spa-pal/UKU201/HARD_v3/Ошибки.docx

Ошибки первого варианта платы.

1. 5 нога JP6 не разведена на GND. Ошибка в принципиалке, указана цепь SGND.
2. Разъем JP4 не входит по отверстиям. Увеличить на пару соток.
