spa-pal/UKU201/HARD_v3/Project Outputs for UKU201/uku201_1.xls

Comment | Designator | Footprint | Quantity
HCM1205X | A1 | zumm | 1.0
796136-1 | BT1 | BAT_HOLD_SMD | 1.0
100n | C1 | _1206 | 1.0
10pF | C2, C4, C9, C10 | _1206 | 4.0
22.0 | C3 | _1206 | 1.0
1.0 | C5, C12, C13, C14, C15, C17, C19, C20, C21, C22, C23, C24, C26, C27, C28, C29 | _1206 | 16.0
LXZ 220x16 | C6, C18, C25 | el3 | 3.0
33pF | C7, C8 | _1206 | 2.0
10.0 | C11 | _1206 | 1.0
1n0 | C16 | _1206 | 1.0
MBR0520 | D1, D2, D3, D4 | _1206d | 4.0
BAV103 | D5 | _1206d | 1.0
LED0 | D6, D7, D8, D9 | el3 | 4.0
BZV55-C5V6 | D10 | _1206d | 1.0
BZV55-C3V3 | D11 | _1206d | 1.0
PBD-10 | JP1 | HDR2X10 | 1.0
PBD-10 | JP2 | HDR2X5 | 1.0
LBH-10R | JP3 | SCM-10MR | 1.0
Header 2 | JP4 | 2EDGR-5.0-2P | 1.0
CORTEX_DEBUG_CONNECTOR_PAL | JP5 | CORTEX_DEBUG_CONNECTOR | 1.0
UART_PORT | JP6 | HDR1X5_uart | 1.0
2EDGR-5.08-02P | JP7 | HDR1X2 | 1.0
BC847 | Q1 | SO-G3 | 1.0
IRF7103 | Q7, Q8 | SO-G8/Y2.2 | 2.0
BC856 | Q501 | SO-G3 | 1.0
0R | R1, R2 | _1206 | 2.0
560R | R3, R4 | _1206 | 2.0
JVR07N | R5, R6 | JVR07N | 2.0
22R | R8 | _1206 | 1.0
5K1 | R9 | _1206 | 1.0
10K | R10, R25, R27, R29, R33, R34, R35, R36, R39, R40, R77, R78 | _1206 | 12.0
2K7 | R11, R12, R32 | _1206 | 3.0
1K0 | R13, R14, R15, R16, R17, R18, R19, R20, R22, R24, R26, R28, R30, R31 | _1206 | 14.0
33K | R21, R23 | _1206 | 2.0
100R | R37, R38 | _1206 | 2.0
SWT-3 | S1 | SWT-6R | 1.0
ISO7231 | U1 | SO-G16/D10.4 | 1.0
MCP2515 | U2 | TSSO6X6-G20/D6.6 | 1.0
TJA1050 | U3 | SO-G8/D5 | 1.0
SN6501DBVR | U4, U8 | SO-G5/P.95 | 2.0
II 130 404 21 01 | U5, U9 | II1304042101 | 2.0
STM32F103RC | U6 | F-QFP10X10-G64/N | 1.0
25LC640 | U7 | SO-G8/D5 | 1.0
ADM2483 | U10 | SO-G16/D10.4 | 1.0
LD1117-3.3 | U11 | DSO-G3 | 1.0
AD158X | U12 | so-g3 | 1.0
8MGz | Y1 | QWARZ1 | 1.0
32768 | Y2 | QWARZ2 | 1.0
10MGz | Y3 | QWARZ1 | 1.0
