spa-pal/UKU201/HARD_v3/Project Outputs for UKU201/uku201.xls

Designator | Comment | Footprint | Quantity
A1 | HCM1205X | zumm | 1.0
BT1 | 796136-1 | BAT_HOLD_SMD | 1.0
C1 | 100n | _1206 | 1.0
C2, C4, C9, C10 | 10pF | _1206 | 4.0
C3 | 22.0 | _1206 | 1.0
C5, C11, C12, C13, C14, C15, C17, C19, C20, C21, C22, C23, C24, C26, C27, C28, C29 | 1.0 | _1206 | 17.0
C6, C18, C25 | LXZ 220x16 | el3 | 3.0
C7, C8 | 33pF | _1206 | 2.0
C16 | 1n0 | _1206 | 1.0
D1, D2, D3, D4 | MBR0520 | _1206d | 4.0
D5 | BAV103 | _1206d | 1.0
D6, D7, D8, D9 | LED0 | el3 | 4.0
D10 | 5V6 | _1206d | 1.0
JP1 | PBD-10 | HDR2X10 | 1.0
JP2 | PBD-10 | HDR2X5 | 1.0
JP3 | LBH-10R | SCM-10MR | 1.0
JP4 | 2EDGR-5.08-02P | 2EDGR-5.0-2P | 1.0
JP5 | CORTEX_DEBUG_CONNECTOR_PAL | CORTEX_DEBUG_CONNECTOR | 1.0
JP6 | UART_PORT | HDR1X5_uart | 1.0
JP7 | 2EDGR-5.08-02P | HDR1X2 | 1.0
Q1 | BC847 | SO-G3 | 1.0
Q7, Q8 | IRF7103 | SO-G8/Y2.2 | 2.0
Q501 | BC856 | SO-G3 | 1.0
R1, R2 | 0R | _1206 | 2.0
R3, R4 | 560R | _1206 | 2.0
R5, R6 | JVR07N | JVR07N | 2.0
R7, R37, R38 | 100R | _1206 | 3.0
R8 | 22R | _1206 | 1.0
R9 | 5K1 | _1206 | 1.0
R10, R25, R27, R29, R33, R34, R35, R36, R39, R77, R78 | 10K | _1206 | 11.0
R11, R12, R32 | 2K7 | _1206 | 3.0
R13, R14, R15, R16, R17, R18, R19, R20, R22, R24, R26, R28, R30, R31 | 1K0 | _1206 | 14.0
R21, R23 | 33K | _1206 | 2.0
S1 | SWT-3 | SWT-6R | 1.0
U1 | ISO7231 | SO-G16/D10.4 | 1.0
U2 | MCP2515 | TSSO6X6-G20/D6.6 | 1.0
U3 | TJA1050 | SO-G8/D5 | 1.0
U4, U8 | SN6501DBVR | SO-G5/P.95 | 2.0
U5, U9 | II 130 404 21 01 | II1304042101 | 2.0
U6 | STM32F103RC | F-QFP10X10-G64/N | 1.0
U7 | 25LC640 | SO-G8/D5 | 1.0
U10 | ADM2483 | SO-G16/D10.4 | 1.0
U11 | LD1117-3.3 | DSO-G3 | 1.0
Y1 | 8MGz | QWARZ1 | 1.0
Y2 | 32768 | QWARZ2 | 1.0
Y3 | 10MGz | QWARZ1 | 1.0
