spa-pal/UKU201/HARD_v3/Project Outputs for UKU201/uku201.xlsx

Designator | Comment | Footprint | Quantity
A1 | HCM1205X | zumm | 1
BT1 | 796136-1 | BAT_HOLD_SMD | 1
C1 | 100n | _1206 | 1
C2, C4, C9, C10 | 10pF | _1206 | 4
C3 | 22.0 | _1206 | 1
C5, C11, C12, C13, C14, C15, C17, C19, C20, C21, C22, C23, C24, C26, C27, C28, C29 | 1.0 | _1206 | 17
C6, C18, C25 | LXZ 220x16 | el3 | 3
C7, C8 | 33pF | _1206 | 2
C16 | 1n0 | _1206 | 1
D1, D2, D3, D4 | MBR0520 | _1206d | 4
D5 | BAV103 | _1206d | 1
D10 | 5V6 | _1206d | 1
JP3 | LBH-10R | SCM-10MR | 1
JP4 | 2EDGR-5.08-02P | 2EDGR-5.0-2P | 1
Q1 | BC847 | SO-G3 | 1
Q7, Q8 | IRF7103 | SO-G8/Y2.2 | 2
Q501 | BC856 | SO-G3 | 1
R3, R4 | 560R | _1206 | 2
R5, R6 | JVR07N | JVR07N | 2
R7, R37, R38 | 100R | _1206 | 3
R8 | 22R | _1206 | 1
R9 | 5K1 | _1206 | 1
R10, R25, R27, R29, R33, R34, R35, R36, R39, R77, R78 | 10K | _1206 | 11
R11, R12, R32 | 2K7 | _1206 | 3
R13, R14, R15, R16, R17, R18, R19, R20, R22, R24, R26, R28, R30, R31 | 1K0 | _1206 | 14
R21, R23 | 33K | _1206 | 2
S1 | SWT-3 | SWT-6R | 1
U1 | ISO7231 | SO-G16/D10.4 | 1
U2 | MCP2515 | TSSO6X6-G20/D6.6 | 1
U3 | TJA1050 | SO-G8/D5 | 1
U4, U8 | SN6501DBVR | SO-G5/P.95 | 2
U5, U9 | II 130 404 21 01 | II1304042101 | 2
U6 | STM32F103RC | F-QFP10X10-G64/N | 1
U7 | 25LC640 | SO-G8/D5 | 1
U10 | ADM2483 | SO-G16/D10.4 | 1
U11 | LD1117-3.3 | DSO-G3 | 1
Y1 | 8MGz | QWARZ1 | 1
Y2 | 32768 | QWARZ2 | 1
Y3 | 10MGz | QWARZ1 | 1
