spa-pal/UKU201/OUT_DOCS/can.pdf

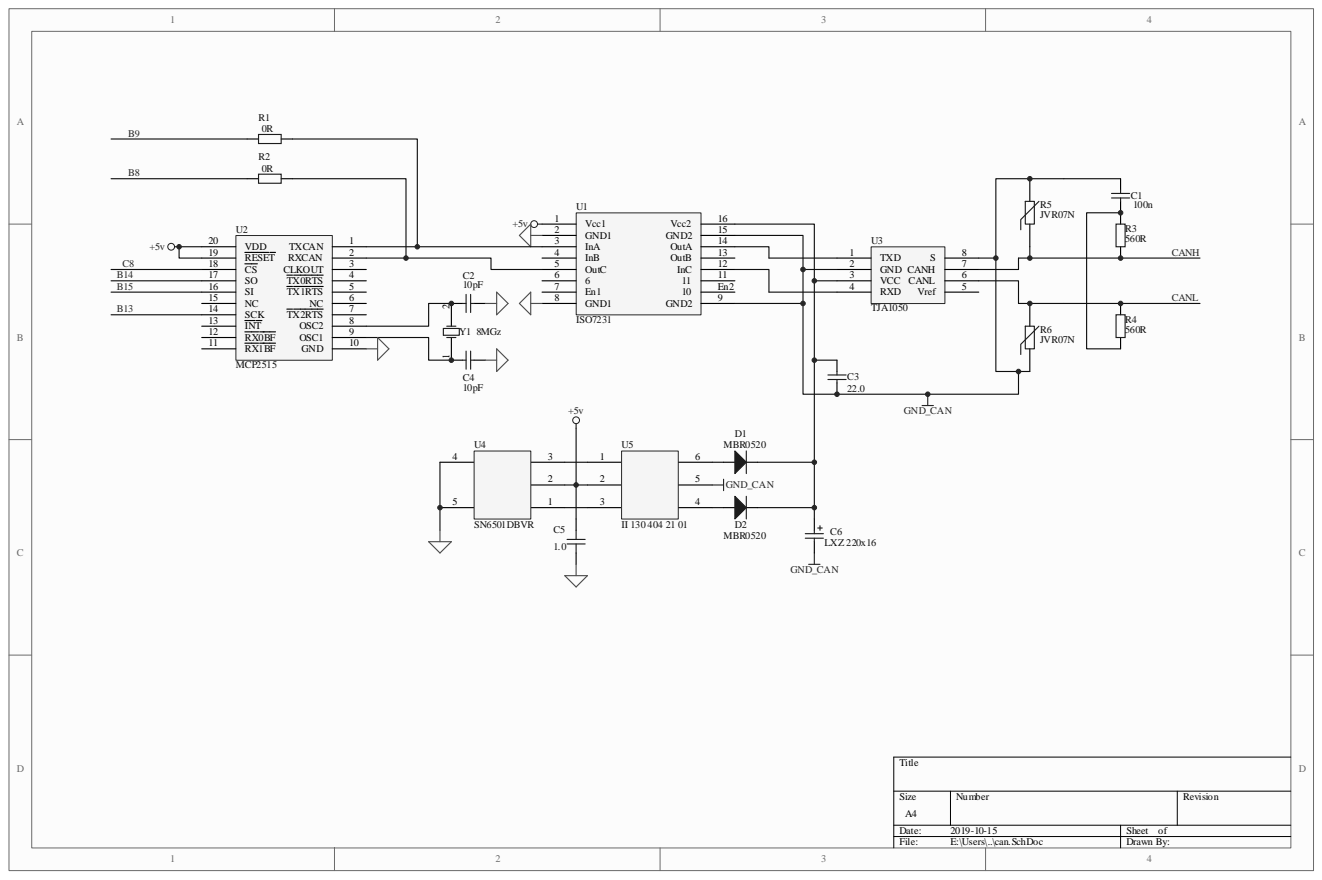
[picture p1: page 1]

Size A4 | Number | Revision

Date: 2019-10-15 | Sheet of
File: E:\Users\..\can.SchDoc | Drawn By:
