spa-pal/UKU201/OUT_DOCS/cpu_board.pdf

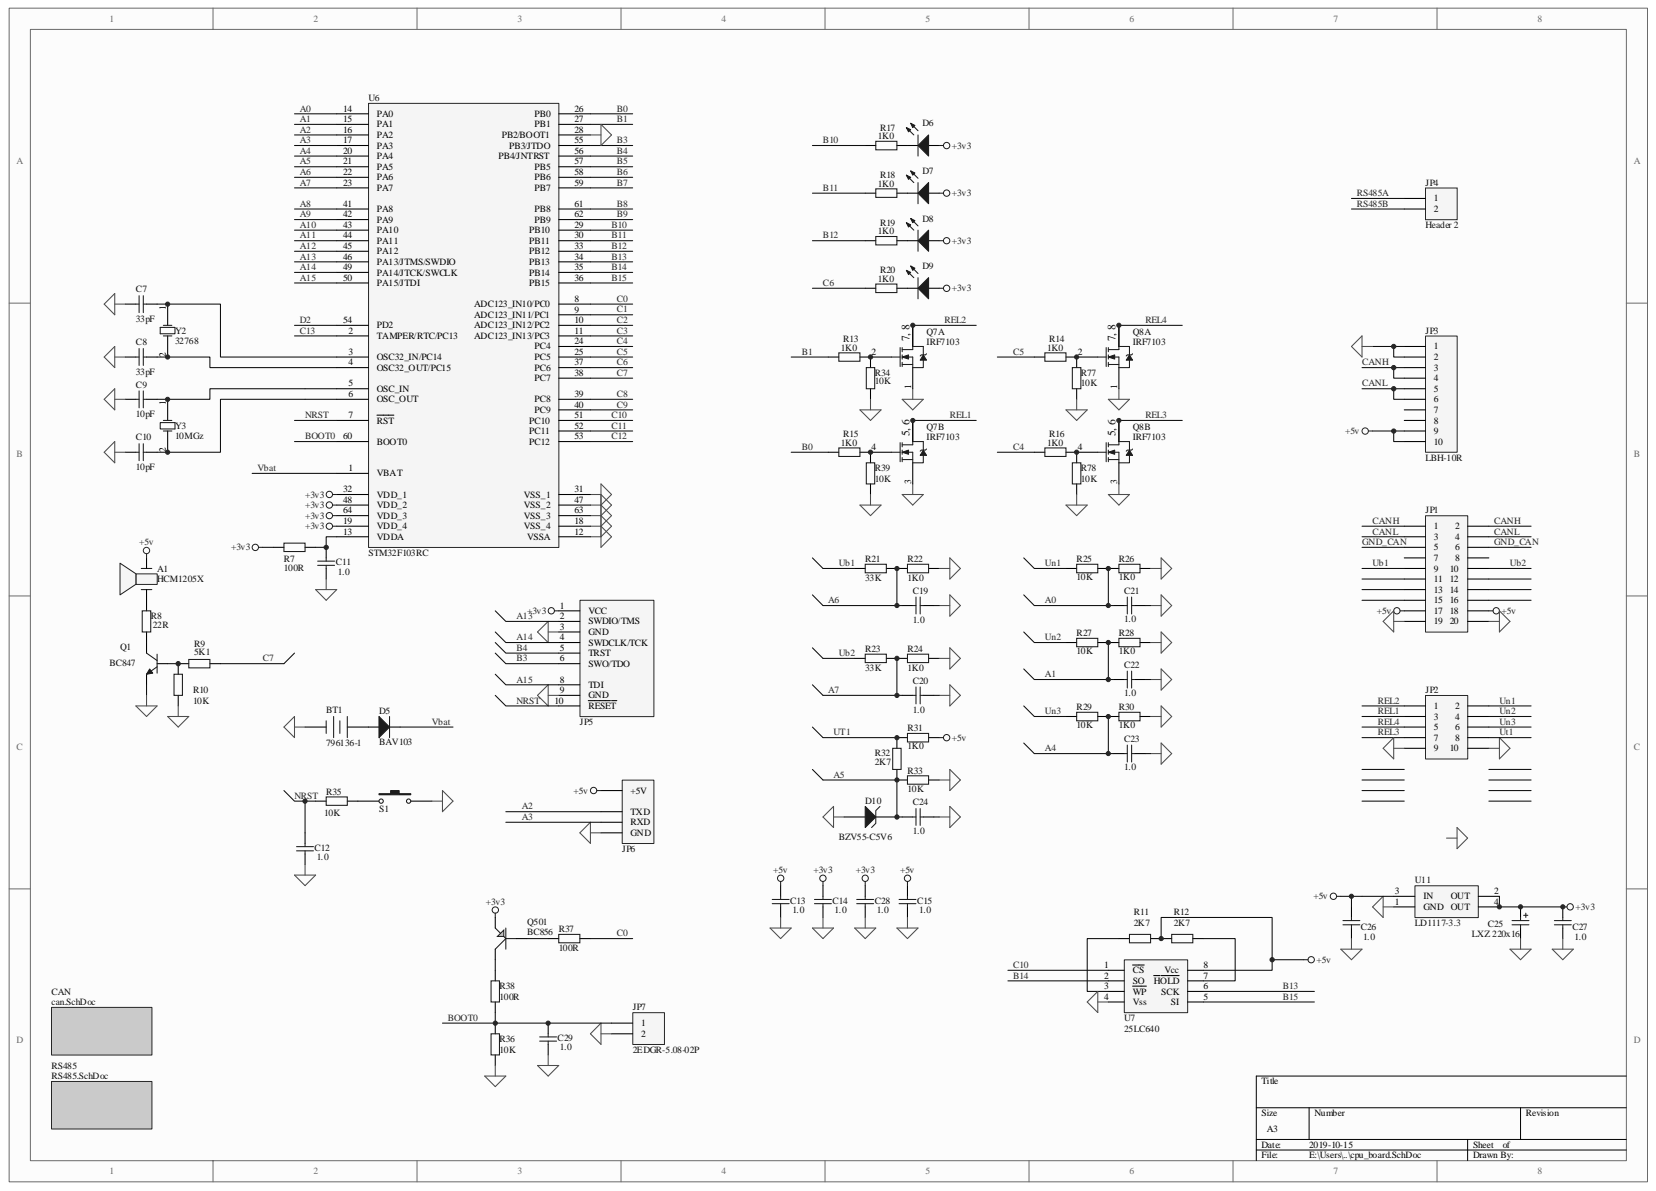
[picture p2: page 1]

Size A3 | Number | Revision

Date: 2019-10-15 | Sheet of
File: E:\Users\..\cpu_board.SchDoc | Drawn By:
