spa-pal/UKU201/OUT_DOCS/pcb.pdf

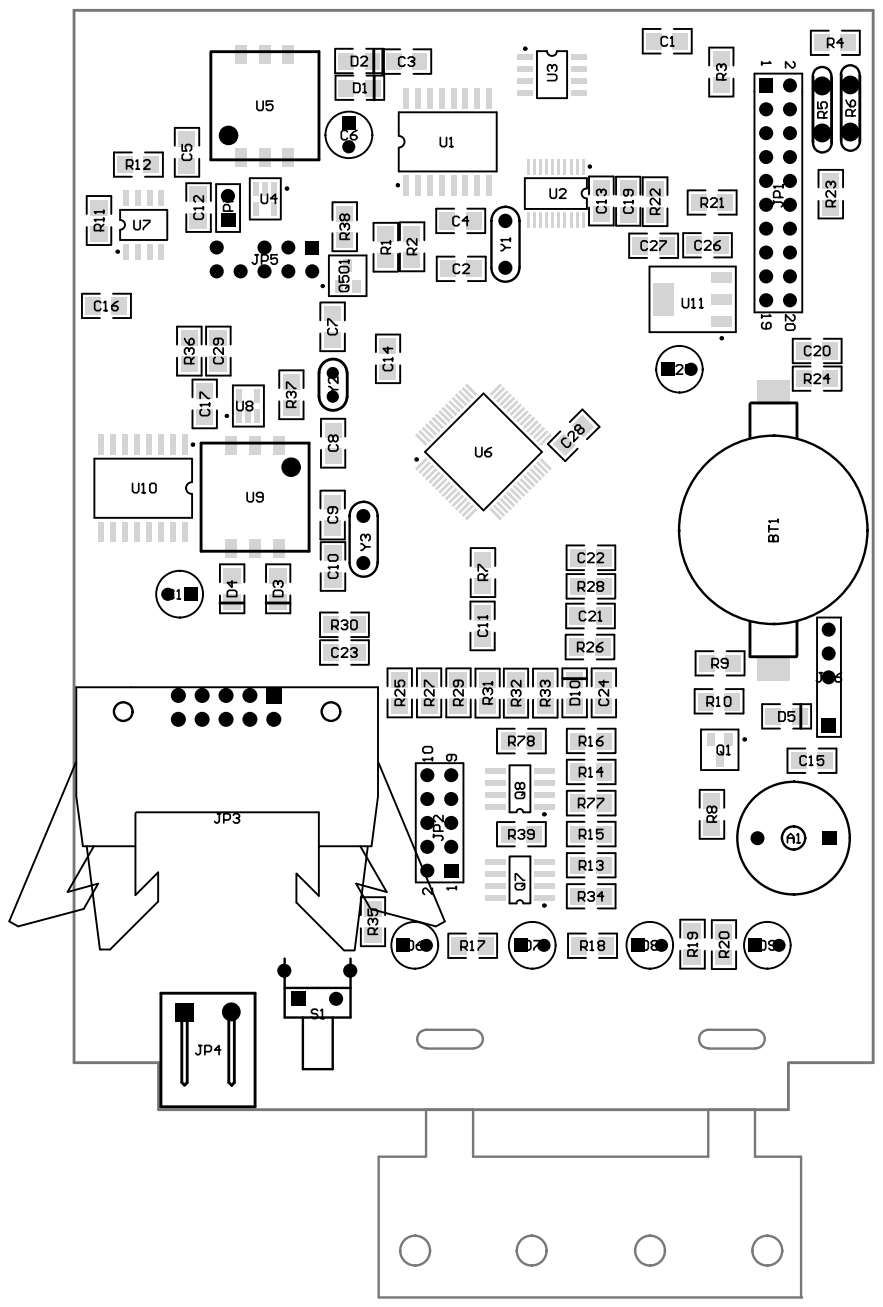
[picture p3: page 1]
