spa-pal/UKU201/OUT_DOCS/rs485.pdf

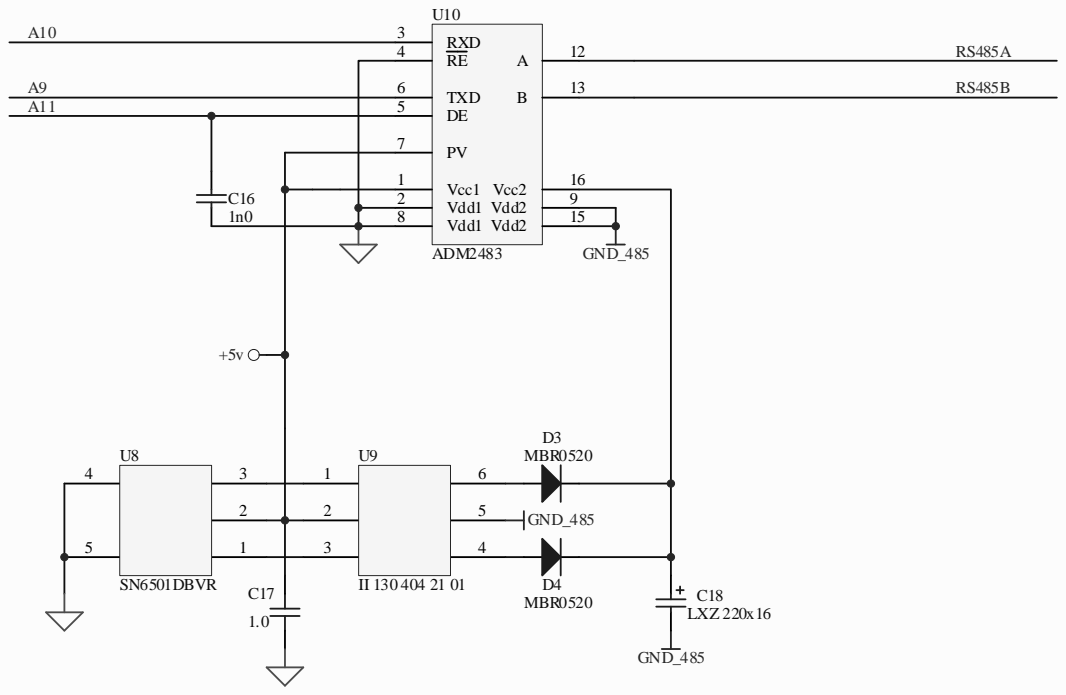
[picture p4: page 1]

Size A4 | Number | Revision

Date: 2019-10-15 | Sheet of
File: E:\Users\..\rs485.SchDoc | Drawn By:
