spa-pal/UKU201/(list of files, drawings)

Other design files:
HARD_v3/can.SchDoc
HARD_v3/cpu_board.SchDoc
HARD_v3/rs485.SchDoc
HARD_v3/uku201.PcbDoc
HARD_v3/UKU201.PrjPCB
