spa-pal/UKU201/SOFT/1/main.c

#include <stm32f10x_conf.h>
#include <string.h>                   /* string and memory functions         */
#include "STM32_Init.h"               /* stm32 initialisation                */
#include <stm32f10x_lib.h>
#include "STM32_Reg.h"
#include "main.h"
#include "uart1.h"
#include "uart2.h"
#include "modbus.h"
#include "25lc640.h"
#include "eeprom_map.h"
#include "memo.h"
#include "mess.h"
#include "control.h"
#include "cmd.h"
#include "full_can.h"
#include "mcp2515.h"
#include "avar_hndl.h"
#include "beep.h"
#include "stm32_rtc.h"

#define	putchar putchar2
#define can1_out mcp2515_transmit

#define SEC_IN_DAY 86400

//***********************************************
//Тайминги
unsigned char t0cnt0, t0cnt1, t0cnt2, t0cnt3, t0cnt4, t0cnt5; 
bool b1000Hz, b100Hz, b50Hz, b1Hz, b10Hz, b5Hz, b2Hz;
bool bFL, bFL2, bFL5;
signed short main_10Hz_cnt;
signed short main_1Hz_cnt;
short main_1HZ_cnt;


//***********************************************
//Данные из EEPROM
signed short ICA_MODBUS_ADDRESS;//Адрес ведомого для выравнивания токов по шине MODBUS-RTU
signed short MODBUS_ADRESS=1;
signed int MODBUS_BAUDRATE=115200;

//***********************************************
//Состояние первичной сети
signed short net_U,net_Ustore,net_Ua,net_Ub, net_Uc, net_Umax;
char bFF,bFF_;
signed short net_F,hz_out,hz_out_cnt,net_F3;
signed char unet_drv_cnt;	//Счетчик на снижение первичного наряжеия
signed char unet_max_drv_cnt; //Счетчик на превышение первичного наряжеия
char net_av;		//аварийность питающей сети 0 - норма, 1 - занижено, 2 - завышено

//***********************************************
//Состояние батарей
BAT_STAT bat[2],bat_ips;
signed short		bat_u_old_cnt;
signed short 		Ib_ips_termokompensat;
signed short		Ib_ips_termokompensat_temp;

//***********************************************
//Состояние источников
BPS_STAT bps[40];

//***********************************************
//Состояние выхода
signed short bps_U;
signed short out_U;
signed short bps_I;
signed short bps_I_phantom;

//***********************************************
//Состояние нагрузки
signed short load_U;
signed short load_I;

//***********************************************
//Ускоренный заряд
signed short speedChrgCurr;			//максимальный ток ускоренного заряда, отображение из ЕЕПРОМ
signed short speedChrgVolt;			//максимальное напряжение ускоренного заряда, отображение из ЕЕПРОМ
signed short speedChrgTimeInHour; 		//максимальное время ускоренного заряда в часах, отображение из ЕЕПРОМ
signed short speedChrgAvtEn;	    		//Автоматическое включение Ускоренного заряда включено/выключено
signed short speedChrgDU;	    		//Просадка напряжения необходимая для включения ускоренного заряда
signed short speedChIsOn;			//Текущее состояние ускоренного заряда вкл/выкл
signed long  speedChTimeCnt;			//Счетчик времени прямой ускоренного заряда
//signed short speedChrgBlckSrc;		//Источник сигнала блокировки, 0-выкл., 1-СК1, 2-СК2
//signed short speedChrgBlckLog;		//Логика сигнала блокировки, 1 - блокировка по замкнутому СК, 0 - по разомкнутому
signed short speedChrgBlckStat;		//Сигнал блокировки для выравнивающего и ускоренного заряда.
char  	   	 speedChrgShowCnt;		//Счетчик показа информационного сообщения
signed short SP_CH_VENT_BLOK;		//Блокировка ускоренного заряда вентиляцией (0-выкл, 1-замыканием, 2-размыканием)
char spch_plazma[2];

//***********************************************
//Новый ускоренный заряд
enum_sp_ch_stat sp_ch_stat=scsOFF,sp_ch_stat_old;
short sp_ch_stat_cnt;
long sp_ch_wrk_cnt;
char speedChargeStartCnt=0;

/*
//***********************************************
//Контроль выходного напряжения
signed short outVoltContrHndlCnt;		//Счетчик, считает в плюс в случае выполнения условия аварии
signed short outVoltContrHndlCnt_;		//Счетчик, считает в плюс в случае отсутствия выполнения условия аварии
char uout_av; */

//***********************************************
//Межблоковая связь
signed short cnt_net_drv;
char max_net_slot;
bool bCAN_OFF;

//***********************************************
//Спецфункции
enum_spc_stat spc_stat;
char spc_bat;
char spc_phase;
unsigned short vz_cnt_s,vz_cnt_s_,vz_cnt_h,vz_cnt_h_;
char bAVZ;
enum_ke_start_stat ke_start_stat;
short cnt_end_ke;
unsigned long ke_date[2];
short __ee_vz_cnt;
short __ee_spc_stat;
short __ee_spc_bat;
short __ee_spc_phase;
char vz_error=0;  		// устанавливается, если выравнивающий заряд заблокирован по вентиляции
char sp_ch_error=0;		// устанавливается, если ускоренный заряд заблокирован по вентиляции
char vz1_error=0;		// устанавливается, если уравнительный заряд заблокирован по вентиляции
char vz2_error=0;		// устанавливается, если формовочный заряд заблокирован по вентиляции

//**********************************************
//Коэффициенты, отображаемые из EEPROM
signed short Ktsrc[2];
signed short Kusrc[2];
signed short Kisrc[2];
signed short Ki0src[2];
signed short Kubat[2];
signed short Kubatm[2];
unsigned short Kibat0[2];
signed short Kibat1[2];
signed short Ktbat[2];
signed short Kunet;
signed short Kunet_ext[3];
signed short Ktext[3];
signed short Kuload;
signed short KunetA;
signed short KunetB;
signed short KunetC;
signed short Kubps;
signed short Kuout=2;

signed short MAIN_IST;
signed short UMAX;
signed short UB0;
signed short UB20;
signed short TMAX;
signed short TSIGN;
signed short AV_OFF_AVT;
signed short USIGN;
signed short UMN;
signed short UMAXN;
signed short ZV_ON;
signed short IKB;
//signed short KVZ;
signed short UVZ;
signed short IMAX_VZ;
signed short IMAX;
signed short IMIN;
signed short APV_ON;
signed short IZMAX;
signed short U0B;
signed short TZAS;
signed short VZ_HR;
signed short TBAT;
signed short U_AVT;
signed short DU;
signed short PAR;
signed short TBATMAX;
signed short TBATSIGN;
signed short UBM_AV;
signed short RELE_LOG;
signed short TBOXMAX;
signed short TBOXREG;
signed short TBOXVENTMAX;
signed short TLOADDISABLE;
signed short TLOADENABLE;
signed short TBATDISABLE;
signed short TBATENABLE;
signed short TVENTON;
signed short TVENTOFF;
signed short TWARMON;
signed short TWARMOFF;
enum_releventsign RELEVENTSIGN;
signed short TZNPN;
signed short UONPN;
signed short UVNPN;
signed short dUNPN;
enum_npn_out NPN_OUT;
enum_npn_sign NPN_SIGN;
signed short TERMOKOMPENS;
signed short TBOXVENTON; 
signed short TBOXVENTOFF;
signed short TBOXWARMON; 
signed short TBOXWARMOFF;
signed short BAT_TYPE;	//Тип батареи. 0 - обычная свинцовая, 1-литиевая COSLIGHT, 2-литиевая SACRED SUN , 3-литиевая ZTT
signed short DU_LI_BAT;	//Параметр, определяющий напряжение содержания литиевой батареи
signed short FORVARDBPSCHHOUR;	//Периодичностьсмены ведущего источника в часах. Если 0 - функция выключена и ведущий первый источник
signed short NUMBAT;
signed short NUMBAT_TELECORE;
signed short NUMIST;
signed short NUMINV;
signed short NUMDT;
signed short NUMSK;
signed short NUMEXT;
signed short NUMAVT;
signed short NUMMAKB;
signed short NUMBYPASS;
signed short NUMBDR;
signed short NUMENMV;
signed short NUMPHASE;
signed short SMART_SPC = 1;
signed short U_OUT_KONTR_MAX;
signed short U_OUT_KONTR_MIN;
signed short U_OUT_KONTR_DELAY;
signed short DOP_RELE_FUNC;
signed short CNTRL_HNDL_TIME;	//Постоянная времени регулирования источников для Телекора
signed short USODERG_LI_BAT;	//Напряжение содержания литиевой батареи
signed short QSODERG_LI_BAT;	//Заряд при котором начинает действовать напряжение содержания литиевой батареи
signed short TVENTMAX;			//Максимальный ресурс вентилятора
signed short ICA_EN;			//Включенность режима выравнивания токов ИПС
signed short ICA_CH;			//Канал связи для выравнивания токов, 0 - MODBUS, 1 - MODBUS-TCP
signed short ICA_MODBUS_ADDRESS;//Адрес ведомого для выравнивания токов по шине MODBUS-RTU
signed short ICA_MODBUS_TCP_IP1,ICA_MODBUS_TCP_IP2,ICA_MODBUS_TCP_IP3,ICA_MODBUS_TCP_IP4;	//IP ведомого для выравнивания токов по шине MODBUS-TCP
signed short ICA_MODBUS_TCP_UNIT_ID;	//UNIT ID ведомого для выравнивания токов по шине MODBUS-TCP
signed short PWM_START;			//Начальный шим для ЭЛТЕХа
signed short KB_ALGORITM;		//2-х или 3-х ступеннчатый алгоритм проверки цепи батареи
signed short REG_SPEED;			//скорость регулирования, 1- стандартная, 2,3,4,5- замедленная в 2,3,4,5 раз
enum_apv_on APV_ON1,APV_ON2;
signed short APV_ON2_TIME;
signed short RS485_QWARZ_DIGIT;
signed short UVENTOFF;			//Напряжение (1в) при котором выключится вентиляция после окончания ВЗ или УСКЗ
signed short VZ_KIND;			//Тип выравнивающего заряда, 0 - обычный(исторический, повышение напряжения на время), 
								//1- высоковольтный, с контролем вентиляции и запросами к оператору
signed short SNTP_ENABLE;
signed short SNTP_GMT;

signed short RELE1SET;			//Настройка срабатываний реле1
								//0бит - инверсия (1 - срабатывание оточиванием, 0 - срабатывание обесточиванием)
								//1бит - авария питающей сети, занижено(1 - вкл)
								//2бит - авария питающей сети, завышено(1 - вкл)
								//3бит - тревога батареи (1 - вкл)
								//4бит - авария батареи (1 - вкл)
								//5бит - тревога выпрямителей (1 - вкл)
								//6бит - авария выпрямителей (1 - вкл)
								//7бит - авария выходного напряжения, занижено (1 - вкл)
								//8бит - авария выходного напряжения, завышено (1 - вкл)
signed short RELE2SET;			//Настройка срабатываний реле2, значение битов как и в реле1
signed short RELE3SET;		   	//Настройка срабатываний реле3, значение битов как и в реле1

signed short UZ_U;
signed short UZ_IMAX;
signed short UZ_T;

signed short FZ_U1;
signed short FZ_IMAX1;
signed short FZ_T1;
signed short FZ_ISW12;
signed short FZ_U2;
signed short FZ_IMAX2;
signed short FZ_T2;

//signed short RELE_SET_MASK[4]={1,2,3,4};

enum_bat_is_on BAT_IS_ON[2];
signed short BAT_DAY_OF_ON[2];
signed short BAT_MONTH_OF_ON[2];
signed short BAT_YEAR_OF_ON[2];
signed short BAT_C_NOM[2];
signed short BAT_RESURS[2];
signed short BAT_C_REAL[2];
//signed short BAT_TYPE[2];

unsigned short AUSW_MAIN;
unsigned long AUSW_MAIN_NUMBER;
unsigned short AUSW_DAY;
unsigned short AUSW_MONTH;
unsigned short AUSW_YEAR;
unsigned short AUSW_UKU;
unsigned short AUSW_UKU_SUB;
unsigned long AUSW_UKU_NUMBER;
unsigned long	AUSW_BPS1_NUMBER;
unsigned long  AUSW_BPS2_NUMBER;
unsigned short AUSW_RS232;
unsigned short AUSW_PDH;
unsigned short AUSW_SDH;
unsigned short AUSW_ETH;

signed short TMAX_EXT_EN[3];
signed short TMAX_EXT[3];
signed short TMIN_EXT_EN[3];
signed short TMIN_EXT[3];
signed short T_EXT_REL_EN[3];
signed short T_EXT_ZVUK_EN[3];
signed short T_EXT_LCD_EN[3];
signed short T_EXT_RS_EN[3];

signed short SK_SIGN[4];
signed short SK_REL_EN[4];
signed short SK_ZVUK_EN[4];
signed short SK_LCD_EN[4];
signed short SK_RS_EN[4];

enum_avz AVZ;

unsigned short HOUR_AVZ;
unsigned short MIN_AVZ;
unsigned short SEC_AVZ;
unsigned short DATE_AVZ;
unsigned short MONTH_AVZ;
unsigned short YEAR_AVZ;
unsigned short AVZ_TIME;

signed short RELE_VENT_LOGIC;
/*
signed short MODBUS_ADRESS;
signed short MODBUS_BAUDRATE;*/
signed short BAT_LINK;

signed short BAT_C_POINT_1_6;  	//Емкость батареи при разряде 1/6 часа
signed short BAT_C_POINT_1_2;  	//Емкость батареи при разряде 1/2 часа
signed short BAT_C_POINT_1;		//Емкость батареи при разряде 1 час
signed short BAT_C_POINT_3;		//Емкость батареи при разряде 3 часа
signed short BAT_C_POINT_5;		//Емкость батареи при разряде 5 часов
signed short BAT_C_POINT_10;	//Емкость батареи при разряде 10 часов
signed short BAT_C_POINT_20;	//Емкость батареи при разряде 20 часов
signed short BAT_U_END_1_6;  	//Конечное напряжение батареи при разряде 1/6 часа
signed short BAT_U_END_1_2;  	//Конечное напряжение батареи при разряде 1/2 часа
signed short BAT_U_END_1;  		//Конечное напряжение батареи при разряде 1 час
signed short BAT_U_END_3;  		//Конечное напряжение батареи при разряде 3 часа
signed short BAT_U_END_5;  		//Конечное напряжение батареи при разряде 5 часов
signed short BAT_U_END_10;  	//Конечное напряжение батареи при разряде 10 часов
signed short BAT_U_END_20;  	//Конечное напряжение батареи при разряде 20 часов
signed short BAT_C_POINT_NUM_ELEM;	//Количество элементов в батарее
signed short BAT_K_OLD;			//Коэффициент старения батареи

//**********************************************
//Показания АЦП на плате измерения тока батареи
signed long ibat_metr_buff_[2];
short bIBAT_SMKLBR;
short bIBAT_SMKLBR_cnt;
short ibat_metr_cnt;

//**********************************************
//Управление регулированием
signed short Isumm;
signed short Isumm_;


//**********************************************
//Инициализация заводских настроек
short factory_settings_hndl_main_iHz_cnt;
char factory_settings_led_reg0, factory_settings_led_reg1;

//***********************************************
//Управление реле
char rele_output_stat;
//0 байт -> "1" реле 1 под ток
//1 байт -> "1" реле 2 под ток
//2 байт -> "1" реле 3 под ток
//3 байт -> "1" реле HV под ток

//***********************************************
//Управление тестовыми процессами
unsigned short test_control_register,test_control_register_old;
char rele_output_stat_test_byte=0;
char rele_output_stat_test_mask=0;
char tst_hndl_cnt;
char test_hndl_rele1_cntrl,test_hndl_rele1_cnt;
char test_hndl_rele2_cntrl,test_hndl_rele2_cnt;
char test_hndl_rele3_cntrl,test_hndl_rele3_cnt;
char test_hndl_releHV_cntrl,test_hndl_releHV_cnt;
char test_hndl_bps_number;
char test_hndl_bps_state;
short test_hndl_bps_cnt;
char zv_test_cnt,zv_test_sign;
char test_led_stat, test_led_cnt;


//***********************************************
//Управление светодиодами
char ledUOUTGOOD;	//Зеленый светодиод "выходное напряжение в норме"
char ledWARNING;  	//Желтый светодиод "тревога в одном из устройств"
char ledERROR;		//Красный светодиод "авария в одном из устройств"
char ledCAN;	   	//Зеленый светодиод "связь по КАН в норме"

//***********************************************
//Чтение журнала в панель
unsigned short log_buff_mb[16];
unsigned short log_deep_mb;
unsigned short log_cmd_mb;
unsigned short log_debug0_mb;
unsigned short log_debug1_mb;

//***********************************************
//Управление ЗВУ панелью
unsigned short hmi_cntrl_reg, hmi_cntrl_reg_old; 	//Регистр комманд/управляющих состояний от панели
unsigned short hmi_cntrl_reg_new;					//Различия между новым и старым командными регистрами
unsigned short hmi_cntrl_fb_reg; 					//Регистр обратной связи комманд/управляющих состояний от панели
unsigned short hmi_notconnect_cnt;					//Счетчик потери связи с HMI, плюсуется каждые 0,1с до HMINOTCONNECTMAX, обнуляется по записи в 1 регистр 3 командой
unsigned short hmi_avg_reg;							//Регистр выравнивания токов от панели
unsigned short hmi_unecc_reg;						//Регистр напряжения поддержания от панели
unsigned short hmi_izmax_reg;						//Регистр максимального тока заряда от панели
//***********************************************
//***********************************************
//***********************************************
//***********************************************
//Отладка
char plazma;
char plazma_tx_cnt;
char plazma_uart1[5];
short plazma_short;
char plazma_debug_0,plazma_debug_1;
short hmi_plazma[9];


#include <stdio.h>

int sendchar(int ch);
struct __FILE {int handle;};
FILE __stdout;


int fputc(int ch, FILE *f) {
return (sendchar(ch));
}

int sendchar(int ch)
{
//while(USART_GetFlagStatus(USART2, USART_FLAG_TXE) == RESET);
putchar2(ch);
return 0;
}

//-----------------------------------------------
void calendar_hndl(void)
{
long tempL;
tempL=RTC->CNTH;
tempL<<=16;
tempL+=RTC->CNTL;

while(tempL>=SEC_IN_DAY)
	{
	char max_day_of_month = 31;
	
	tempL-=SEC_IN_DAY;

	
	if( ((BKP->DR2)==4)	|| ((BKP->DR2)==6) || ((BKP->DR2)==9) || ((BKP->DR2)==11) )	max_day_of_month = 30;
	if((BKP->DR2)==2)
		{
		if((BKP->DR1)%4) max_day_of_month = 28;
		else max_day_of_month = 29;
		}

	if((BKP->DR3)<max_day_of_month)
		{
		PWR->CR	|= PWR_CR_DBP;
		BKP->DR3++;
		PWR->CR	&= ~PWR_CR_DBP;		
		}
	else 
		{
		PWR->CR	|= PWR_CR_DBP;
		BKP->DR3=1;
		BKP->DR2++;
		if((BKP->DR2)>12)
			{
			(BKP->DR2)=1;
			(BKP->DR1)++;
			}
		PWR->CR	&= ~PWR_CR_DBP;
		}

//	tempL-=SEC_IN_DAY;
/*	PWR->CR	|= PWR_CR_DBP;
	RTC->CNTH=tempL>>16;
	RTC->CNTL=(short)tempL;
	BKP->DR3++;
	PWR->CR	&= ~PWR_CR_DBP;*/
				PWR->CR   |= PWR_CR_DBP;
				RTC->CRL  |=  RTC_CRL_CNF;
				RTC->CNTH=(short)(tempL>>16);
				RTC->CNTL=(short)tempL;
				RTC->CRL  &= ~RTC_CRL_CNF;
				while (!((RTC->CRL)&RTC_CRL_RTOFF)){};
				PWR->CR   &= ~PWR_CR_DBP;
	}

}

//-----------------------------------------------
void factory_settings_hndl(void)
{
short tempS;
tempS=(RTC->CNTL)-(BKP->DR4);
if((tempS>7)&&(tempS<14)&&((BKP->DR5)==0))
	{
	PWR->CR	|= PWR_CR_DBP;
	BKP->DR5=1;
	PWR->CR	&= ~PWR_CR_DBP;
	factory_settings_led_reg0=8;
	}
else if((tempS>7)&&(tempS<14)&&((BKP->DR5)==1))
	{
	PWR->CR	|= PWR_CR_DBP;
	BKP->DR5=2;
	PWR->CR	&= ~PWR_CR_DBP;
	factory_settings_led_reg0=8;
	}
else if((tempS>7)&&(tempS<14)&&((BKP->DR5)==2))
	{
	PWR->CR	|= PWR_CR_DBP;
	BKP->DR5=3;
	PWR->CR	&= ~PWR_CR_DBP;
	lc640_write_int(EE_MODBUS_ADRESS,1);
	lc640_write_int(EE_MODBUS_BAUDRATE,960);
	factory_settings_led_reg1=6;
	}
/*else
	{
	PWR->CR	|= PWR_CR_DBP;
	BKP->DR5=0;
	PWR->CR	&= ~PWR_CR_DBP;
	}  */
PWR->CR	|= PWR_CR_DBP;
BKP->DR4=RTC->CNTL;
PWR->CR	&= ~PWR_CR_DBP;

if(factory_settings_hndl_main_iHz_cnt<1000)factory_settings_hndl_main_iHz_cnt++;
if(factory_settings_hndl_main_iHz_cnt==100)
	{
	PWR->CR	|= PWR_CR_DBP;
	BKP->DR5=0;
	PWR->CR	&= ~PWR_CR_DBP;
	}
}	

//-----------------------------------------------
void log_hndl(void)
{
char log_hndl_buff[32];
signed short event_ptr,read_event_ptr,lc640_adr;

log_debug0_mb++;

if((log_cmd_mb>=0)&&(log_cmd_mb<=63))
	{
	event_ptr=lc640_read_int(PTR_EVENT_LOG);
	read_event_ptr=event_ptr-log_cmd_mb;
	if(read_event_ptr<0)read_event_ptr+=63;
	lc640_adr=EVENT_LOG+(read_event_ptr*32);

	lc640_read_long_ptr(lc640_adr,&log_hndl_buff[0]);
	lc640_adr+=4;
	lc640_read_long_ptr(lc640_adr,&log_hndl_buff[4]);
	lc640_adr+=4;
	lc640_read_long_ptr(lc640_adr,&log_hndl_buff[8]);
	lc640_adr+=4;
	lc640_read_long_ptr(lc640_adr,&log_hndl_buff[12]);
	lc640_adr+=4;
	lc640_read_long_ptr(lc640_adr,&log_hndl_buff[16]);
	lc640_adr+=4;
	lc640_read_long_ptr(lc640_adr,&log_hndl_buff[20]);
	lc640_adr+=4;
	lc640_read_long_ptr(lc640_adr,&log_hndl_buff[24]);
	lc640_adr+=4;
	lc640_read_long_ptr(lc640_adr,&log_hndl_buff[28]);

	log_buff_mb[0]=log_hndl_buff[0];
	log_buff_mb[1]=log_hndl_buff[1];
	log_buff_mb[2]=log_hndl_buff[2];
					//Расшифровка первых трех регистров				// 'U',0,'R'   - перезагрузка УКУ, время события находится в слоте "начало события"
																	// 'P',0,'A'   - авария по заниженному первичному питанию, если в слоте "окончание события" символы 'A' значит авария не снята, если снята то в слоте "Числовой параметр события №2" записано минимальное напряжение за время действия аварии (1В)
																	// 'P',0,'В'   - авария по завышенному первичному питанию, если в слоте "окончание события" символы 'A' значит авария не снята, если снята то в слоте "Числовой параметр события №2" записано максимальное напряжение за время действия аварии (1В)
																	// 'Q','A','D' - авария по заниженному выходному напряжению, если в слоте "окончание события" символы 'A' значит авария не снята, в слоте "Числовой параметр события №1" записано выходное напряжение на момент возникновения аварии (0.1В)
																	// 'Q','A','U' - авария по завышенному выходному напряжению, если в слоте "окончание события" символы 'A' значит авария не снята, в слоте "Числовой параметр события №1" записано выходное напряжение на момент возникновения аварии (0.1В)
																	// 'S' 		   - авария выпрямителя
																	//      X      - номер выпрямителя, счет с нуля
																	//         'T' - авария по перегреву выпрямителя
																	//         'u' - авария по снижению напряжения выпрямителя ниже порога аварии
																	//         'U' - авария по превышению напряжения выпрямителя выше порога аварии
																	//         'L' - авария по пропаданию связи с выпрямителем
																	//                  если в слоте "окончание события" символы 'A' значит авария не снята, параметров нет
																	// 'B',0,'C'   - авария батареи. Процедура проверки наличия батареи не выявила батарею, если в слоте "окончание события" символы 'A' значит авария не снята, параметров нет 
																	// 'B',0,'K'   - контроль емкости батареи. Процедура проверки наличия батареи не выявила батарею, если в слоте "окончание события" символы 'A' значит авария не снята, параметров нет 
																	//										   в слоте "Числовой параметр события №1" - измеренная емкость батареи (0.1А*ч)
																	//										   в слоте "Числовой параметр события №3" - напряжение батареи в момент окончания процесса контроля емкости(0.1В)
																	//										   в слоте "Числовой параметр события №4" - напряжение батареи в момент начала процесса контроля емкости(0.1В)
	log_buff_mb[3]=(log_hndl_buff[8]<<8)+log_hndl_buff[9];			//Начало события, год и месяц
	log_buff_mb[4]=(log_hndl_buff[10]<<8)+log_hndl_buff[12];		//Начало события, день и час 
	log_buff_mb[5]=(log_hndl_buff[13]<<8)+log_hndl_buff[14];		//Начало события, минуты и секунды
	log_buff_mb[6]=(log_hndl_buff[8]<<8)+log_hndl_buff[9];			//Окончание события, год и месяц 
	log_buff_mb[7]=(log_hndl_buff[10]<<8)+log_hndl_buff[12];		//Окончание события, день и час 
	log_buff_mb[8]=(log_hndl_buff[13]<<8)+log_hndl_buff[14];		//Окончание события, минуты и секунды
	log_buff_mb[9]=(log_hndl_buff[5]<<8)+log_hndl_buff[4];			//Числовой параметр события	№1
	log_buff_mb[10]=(log_hndl_buff[25]<<8)+log_hndl_buff[24];		//Числовой параметр события	№2
	log_buff_mb[11]=(log_hndl_buff[7]<<8)+log_hndl_buff[6];			//Числовой параметр события	№3
	log_buff_mb[12]=(log_hndl_buff[11]<<8)+log_hndl_buff[15];		//Числовой параметр события	№4
	}

else if(log_cmd_mb==2000)
	{
	log_deep_mb = lc640_read_int(CNT_EVENT_LOG);
	log_cmd_mb=0;
	}

else if(log_cmd_mb==1000)
	{
	lc640_write(CNT_EVENT_LOG,0);
	lc640_write(PTR_EVENT_LOG,0);
	log_deep_mb = lc640_read_int(CNT_EVENT_LOG);
	log_cmd_mb=0;
	}

else if(log_cmd_mb==10001)
	{
	avar_unet_hndl(1);
	log_deep_mb = lc640_read_int(CNT_EVENT_LOG);
	log_cmd_mb=0;
	}
else if(log_cmd_mb==20001)
	{
	avar_unet_hndl(0);
	log_deep_mb = lc640_read_int(CNT_EVENT_LOG);
	log_cmd_mb=0;
	}
else if(log_cmd_mb==10002)
	{
	avar_unet_hndl(2);
	log_deep_mb = lc640_read_int(CNT_EVENT_LOG);
	log_cmd_mb=0;
	}
else if(log_cmd_mb==20002)
	{
	avar_unet_hndl(0);
	log_deep_mb = lc640_read_int(CNT_EVENT_LOG);
	log_cmd_mb=0;
	}
}

//-----------------------------------------------
char kalibrate_func(short in)
{
char parametr, make;

parametr=(char)((in&0xff00)>>8);
make=(char)(in&0x00ff);

if(parametr==1)		//Температура датчика батареи
	{
	signed short temp_SS;
	temp_SS=lc640_read_int(EE_KTBAT1);
	if(make==0x11)
		{
		temp_SS++;
		}
	else if(make==0x12)
		{
		temp_SS+=10;
		}
	else if(make==0x21)
		{
		temp_SS--;
		}
	else if(make==0x22)
		{
		temp_SS-=10;
		}
	lc640_write_int(EE_KTBAT1,temp_SS);
	}
}
									

//-----------------------------------------------
void net_drv(void)
{
if(can_error_cntr<1000)
	{
	can_error_cntr++;
	} 



max_net_slot=32;
//if(NUMINV) max_net_slot=MINIM_INV_ADRESS+NUMINV;
//gran_char(&max_net_slot,0,MAX_NET_ADRESS);

if(++cnt_net_drv>max_net_slot) 
	{
	cnt_net_drv=-4;
	//LPC_GPIO2->FIODIR|=(1UL<<7);
	//LPC_GPIO2->FIOPIN^=(1UL<<7);
	///if(bCAN_INV)bCAN_INV=0;
	///else bCAN_INV=1;

	} 



if((cnt_net_drv>=0)&&(cnt_net_drv<=4)) // с 1 по 12 посылки адресные
	{
	//cnt_net_drv=2; 
	if(mess_find_unvol(MESS2NET_DRV))
		{
		if(mess_data[0]==PARAM_BPS_NET_OFF)
			{
			//mess_data[1]=1;
//			if(sub_ind1==cnt_net_drv)
//				{
				return;
//				}
			}
		}
			   
	if(!bCAN_OFF)can1_out(cnt_net_drv,cnt_net_drv,GETTM,bps[cnt_net_drv]._flags_tu,*((char*)(&bps[cnt_net_drv]._vol_u)),*((char*)((&bps[cnt_net_drv]._vol_u))+1),*((char*)(&bps[cnt_net_drv]._vol_i)),*((char*)((&bps[cnt_net_drv]._vol_i))+1));
     
	if(cnt_net_drv<=32)
	     {
	     if(bps[cnt_net_drv]._cnt<CNT_SRC_MAX)
   	 		{    
   	 		bps[cnt_net_drv]._cnt++;
   	 		if( (bps[cnt_net_drv]._cnt>=CNT_SRC_MAX) && (!net_av) && (!(bps[cnt_net_drv]._av&0x08)) && (cnt_net_drv<NUMIST) ) 
   	 			{
   	 			avar_bps_hndl(cnt_net_drv,3,1);
   	 			} 
   	 		}
		else bps[cnt_net_drv]._cnt=CNT_SRC_MAX;	
						
		if((bps[cnt_net_drv]._cnt>=3)&&(bps[cnt_net_drv]._cnt_old<3))bps[cnt_net_drv]._cnt_more2++;
		bps[cnt_net_drv]._cnt_old=bps[cnt_net_drv]._cnt;
	     }
	}

else if(cnt_net_drv==-4)
	{
    if(!bCAN_OFF)can1_out(GETTM_IBATMETER,GETTM_IBATMETER,0,0,0,0,0,0);
//    ibat_metr_cnt++;
	}

else if(cnt_net_drv==-1)
	{
//    if(!bCAN_OFF)can1_out(PUT_BDR,PUT_BDR,bdr_transmit_stat,bdr_transmit_stat,*((char*)((&UMAX))+1),*((char*)(&DU)),*((char*)((&DU))+1),0);
//    plazma_pavlik++;
	}

else if(cnt_net_drv==-3)
	{
	//UMAX=1000;
	if(!bCAN_OFF)can1_out(0xff,0xff,MEM_KF,*((char*)(&UMAX)),*((char*)((&UMAX))+1),*((char*)(&DU)),*((char*)((&DU))+1),0);
	} 
     
else if(cnt_net_drv==13)
	{
	} 

else if(cnt_net_drv==14)
	{                 
	}
	

	
else if(cnt_net_drv==-2)
	{
	if(!bCAN_OFF)can1_out(0xff,0xff,MEM_KF1,*((char*)(&TMAX)),*((char*)((&TMAX))+1),*((char*)(&TSIGN)),*((char*)((&TSIGN))+1),(char)TZAS);
	}


else if(cnt_net_drv==19)
	{
	}
	
/*	
else if((cnt_net_drv>=0)&&(cnt_net_drv<32))
	{
	if(!bCAN_OFF)
		{
		can1_out(cnt_net_drv,cnt_net_drv,GETTM,bps[cnt_net_drv]._flags_tu,*((char*)(&bps[cnt_net_drv]._vol_u)),*((char*)((&bps[cnt_net_drv]._vol_u))+1),*((char*)(&bps[cnt_net_drv]._vol_i)),*((char*)((&bps[cnt_net_drv]._vol_i))+1));
		}
	if(bps[cnt_net_drv]._cnt<CNT_SRC_MAX)
		{    
		bps[cnt_net_drv]._cnt++;

		}
	else bps[cnt_net_drv]._cnt=CNT_SRC_MAX;
						
	if((bps[cnt_net_drv]._cnt>=3)&&(bps[cnt_net_drv]._cnt_old<3))bps[cnt_net_drv]._cnt_more2++;
	bps[cnt_net_drv]._cnt_old=bps[cnt_net_drv]._cnt;
	}*/
}
/*
//-----------------------------------------------
void delay_us(long del)
{
long temp;
temp=5*del;

while (--temp);
return;
}*/

//***********************************************
//***********************************************
//***********************************************
//***********************************************
//***********************************************
void SysTick_Handler (void) 
{
//GPIOC->ODR^=(1<<6);
b1000Hz=(bool)1;

	if((GPIOC->IDR&=(1<<1)))bFF=1;
	else bFF=0;
	if(bFF!=bFF_) hz_out++;
	bFF_=bFF;
	
if(++t0cnt0>=20)
     {
     t0cnt0=0;
     b50Hz=(bool)1;
     }
     
if(++t0cnt1>=10)
     {
     t0cnt1=0;
     b100Hz=(bool)1;

     if(++t0cnt2>=10)
	 	{
		t0cnt2=0;
		b10Hz=(bool)1;
		beep_drv(); 
		}

     if(++t0cnt3>=20)
	 	{
		t0cnt3=0;
		b5Hz=(bool)1;
		if(bFL5)bFL5=(bool)0;
		else bFL5=(bool)1;     
		}

	if(++t0cnt4>=50)
		{
		t0cnt4=0;
		b2Hz=(bool)1;
		if(bFL2)bFL2=(bool)0;
		else bFL2=(bool)1;
		}         

	if(++t0cnt5>=100)
		{
		t0cnt5=0;
		b1Hz=(bool)1;
		if(bFL)bFL=(bool)0;
		else bFL=(bool)1;
		if(main_1Hz_cnt<10000) main_1Hz_cnt++;
		}

     hz_out_cnt++;
     if(hz_out_cnt>=500)
	     {	
	     hz_out_cnt=0;
	     net_F=hz_out;
	     hz_out=0;
	     }
	}
if(modbus_timeout_cnt)
	{
	modbus_timeout_cnt--;
	if(modbus_timeout_cnt==0)
		{
		//bMODBUS_TIMEOUT=1;
		modbus_in();
		}
	}
/*else if (modbus_timeout_cnt>=5)
	{
	modbus_timeout_cnt=0;
	//bMODBUS_TIMEOUT=0;
	}	*/
} 

/*----------------------------------------------------------------------------
 *        Main: 
 *---------------------------------------------------------------------------*/

int main (void) 
{



stm32_Init();
spi2_config();
//SysTick->LOAD  = 544;  
//                            
//dac_init();
//init_display ();
//plazma1=SD_Reset();
//i2c_init();
//tx1_restart=1;
plazma=1;
rtc_init();

memo_first_init ();
memo_read();
stm32_Usart1Setup(MODBUS_BAUDRATE*10UL);
lc640_write_int(0x0010,0x64);
adc_init();
can_mcp2515_init();
kb_init();

//calendar_hndl();
factory_settings_hndl();
//beep_init(0x00000005,'A');

//lc640_write_int(EE_NUMPHASE,3);
//lc640_write_int(EE_MODBUS_BAUDRATE,960);
//lc640_write_int(EE_MODBUS_ADRESS,1);
calendar_hndl();
//lc640_write_int(EE_BAT_C_POINT_20,1234);

while (1) 
	{
	//can_rotor[1]++;
	//delay_us(100000); 
	//GPIOB->ODR^=(1<<10)|(1<<11)|(1<<12);
	//GPIOC->ODR^=(1<<6);
	if(bMODBUS_TIMEOUT)modbus_in();
	if (b1000Hz) 
		{
		
		b1000Hz=(bool)0;
		//
		can_mcp2515_hndl();
		}
	if(bMODBUS_TIMEOUT)modbus_in();
	if (b100Hz) 
		{
		b100Hz=(bool)0;
		adc_drv();
		//TMAX=80;
		//TSIGN=80;
		
/*		bps[0]._flags_tu=0;
		bps[1]._flags_tu=1;	*/
		//NUMIST=3;
		net_drv();
		if(modbus_error_cntr<1000)
			{
			modbus_error_cntr++;
			} 

		//log_hndl();		//Обработка запросов на чтение журнала
		}
	if(bMODBUS_TIMEOUT)modbus_in();
	if (b10Hz) 
		{
		char i;

		b10Hz=(bool)0;
	//	adc_drv();
		ext_drv();
		u_necc_hndl();
		cntrl_hndl();
		for(i=0;i<NUMIST;i++)bps_drv(i);
		bps_hndl();
//		calendar_hndl();
		led_hndl();		//Управление светодиодами, логическое
		led_drv();		//Управление светодиодами, физическое
	   	rele_hndl(); 	//Логическое управление реле
		rele_drv(); 	//Физическое управление реле
		tst_hndl();		//обслуживание тестовых операций
		mess_hndl();
		unet_drv();
		hmi_cntrl_hndl(); 	//Управление от HMI
		}   
	if (b5Hz) 
		{
		b5Hz=(bool)0; 
		//can1_out(cnt_net_drv,cnt_net_drv,GETTM,bps[cnt_net_drv]._flags_tu,*((char*)(&bps[cnt_net_drv]._vol_u)),*((char*)((&bps[cnt_net_drv]._vol_u))+1),*((char*)(&bps[cnt_net_drv]._vol_i)),*((char*)((&bps[cnt_net_drv]._vol_i))+1));
     
		memo_read();
		//TZAS=3;
		

		matemat();	//Вычисление всех величин

		can1_out(0xff,0xff,MEM_KF1,*((char*)(&TMAX)),*((char*)((&TMAX))+1),*((char*)(&TSIGN)),*((char*)((&TSIGN))+1),(char)TZAS);

		}
	if (b2Hz) 
		{
		b2Hz=(bool)0;

		avt_klbr_hndl_();	//драйвер автоматической колибровки БПСов и шунта

		}

	if (b1Hz) 
		{
		b1Hz=(bool)0;
	   	
		main_1HZ_cnt++;
		if(main_1HZ_cnt>1000)main_1HZ_cnt=0;
		num_necc_hndl();
		kb_hndl();

		outVoltContrHndl();		//контроль выходного напряжения
		vent_resurs_hndl();		//ресурс вентиляторов

		plazma_tx_cnt++;
		
		//GPIOB->ODR^=(1<<10);
	   	//printf ("\033c");
		//putchar1('a');
		//uart_out1 (4,'a','b','c',plazma_tx_cnt,0,0);
		//uart_out2 (4,'d','e','f',plazma_tx_cnt,0,0);
		//printf("MAMA MILA RAMU");
		//printf("plazma = %02d\r\n", plazma++);
		//printf("plazma = %d; %d; %d; %d;\r\n  rx_wr_index1 = %d\r\n", plazma_uart1[0], plazma_uart1[1], plazma_uart1[2], plazma_uart1[3], rx_wr_index1);
		//putchar2('a');
		//plazma_short = lc640_read_int(0x0010);
		//printf("adc_buff = %d; %d; %d; %d; %d; %d; %d; %d; %d; %d;\r\n", adc_buff_[0], adc_buff_[1], adc_buff_[2], adc_buff_[3], adc_buff_[4],  adc_buff_[5],  adc_buff_[6],  adc_buff_[7],adc_ch, adc_cnt);
		//printf("rtc = %x; %x; %x; %x;\r\n", RTC->CRH, RTC->CRL, RTC->CNTH, RTC->CNTL);
		//printf("cnt = %2d; %2d; %2d; %2d;\r\n", bps[0]._cnt, bps[1]._cnt, bps[2]._cnt, bps[3]._cnt);
		//printf("Ktbat[0] = %5d;\r\n", Ktbat[0]);
		//printf("%5d   %5d   %5d   %5d   %5d   \r\n", plazma_uart1[0], plazma_uart1[1], plazma_uart1[2], plazma_uart1[3], plazma_uart1[4]);
		//spi2(0x55);
		//printf("%5d   %5d   %5d   %5d   %5d   %5d   %5d   %5d   %5d   %5d   %5d   %5d   %5d   %5d   %5d   %5d   \r\n", adc_buff[0][0], adc_buff[0][1], adc_buff[0][2], adc_buff[0][3], adc_buff[0][4], adc_buff[0][5], adc_buff[0][6], adc_buff[0][7], adc_buff[0][8], adc_buff[0][9], adc_buff[0][10], adc_buff[0][11], adc_buff[0][12], adc_buff[0][13], adc_buff[0][14], adc_buff[0][15]);
		//printf("%3d   %3d   %3d   %3d   %3d    %3d \r\n", bps[0]._cnt, bps[1]._cnt, bps[2]._cnt, can_rotor[1], can_rotor[2], bps[0]._Ti);
		//printf("num_necc= %3d   %d   %d   %3d   %3d    %3d \r\n", num_necc, ibat_metr_buff_[0], ibat_metr_buff_[1], Kibat1[0], Ib_ips_termokompensat, bps[0]._Ti);
		//printf("flags_tu= %2x   %2x   %2x  \r\n", bps[0]._flags_tu, bps[1]._flags_tu, bps[2]._flags_tu);
		//printf("RELESET= %2x   %2x   %2x  \r\n", RELE1SET, RELE2SET, RELE3SET);
		//printf("\r\n bat_temper = %d num_necc= %d  u_necc= %3d  cntrl_stat= %4d  UB0= %3d  UB20= %3d  bps_U= %3d  DU= %3d \r\n",bat[0]._Tb ,num_necc, u_necc, cntrl_stat, UB0, UB20, bps_U, DU);
		//printf("flags_tu= %2X %2X %2X  state= %2X %2X %2X  av= %2X %2X %2X flags_tm= %2X %2X %2X umin_av_cnt= %d %d %d\r\n", bps[0]._flags_tu,bps[1]._flags_tu,bps[2]._flags_tu, bps[0]._state, bps[1]._state, bps[2]._state ,bps[0]._av ,bps[1]._av, bps[2]._av, bps[0]._flags_tm ,bps[1]._flags_tm, bps[2]._flags_tm, bps[0]._umin_av_cnt ,bps[1]._umin_av_cnt, bps[2]._umin_av_cnt);
	   	//printf("%d  %d  %d  %d \r\n", bps[0]._x_, bps[1]._x_, bps[2]._x_, bps[3]._x_);
		//printf("%2d; %4d; %2d; %2d;\r\n", avt_klbr_phase_ui, modbus_register_1022, bps[2]._cnt, bps[3]._cnt);
		//printf("%3d   %3d   %3d   %3d   %3d   %3d   %3d   %3d   %3d   %3d\r\n", cntrl_hndl_plazma, bps[0]._cnt, bps[1]._cnt, bps[2]._cnt,UMAXN,MODBUS_BAUDRATE,/*MODBUS_ADRESS*/test_hndl_rele2_cntrl,/*plazma_uart1[2]*/test_hndl_rele2_cnt,/* NUMIST*/rele_output_stat_test_byte, /*NUMPHASE*/ rele_output_stat_test_mask);
		//printf("net_U= %3d  %3d  %3d  %3d  u_necc = %4d  hmi_unecc_reg = %4d hmi_izmax_reg = %4d UMAXN = %4d\r\n", net_U, net_Ua, net_Ub, net_Uc, u_necc, hmi_unecc_reg, hmi_izmax_reg, RELE1SET, UMN, UMAXN);
		///printf("%3d; %3d; %3d; %3d;\r\n", net_Umax, UMAXN, unet_max_drv_cnt);
		///printf("log_cmd = %3d log_deep = %3d log_debug0 = %4d log_debug1 = %4d  %3d;\r\n", log_cmd_mb, log_deep_mb, log_debug0_mb, log_debug1_mb, unet_max_drv_cnt);
		 printf("%3d; %3d; %3d; %3d;\r\n", outVoltContrHndlCntUp, outVoltContrHndlCntDn, uout_av);
		// контроль выходного напряжения printf("out_U = %4d out_U_max = %4d out_U_min = %4d delay = %4d max_cnt = %4d  min_cnt = %4d uout_av = %3d;\r\n", out_U, U_OUT_KONTR_MAX, U_OUT_KONTR_MIN, U_OUT_KONTR_DELAY, outVoltContrHndlCntUp, outVoltContrHndlCntDn, uout_av);
		// бипер printf("beep_stat = %8x beep_stat_temp = %8x beep_stat_cnt = %4d\r\n", beep_stat, beep_stat_temp, beep_stat_cnt);
		// управление регистрами в калибровке printf("modbus_register_998 = %4d  modbus_register_999 = %4d \r\n", modbus_register_998, modbus_register_999);
		//	printf("Ib = %4.1d   IZMAX_ = %4d  PWM = %4d\r\n", Ib_ips_termokompensat, IZMAX_, cntrl_stat);

		//printf("C_20=%4d C_10=%4d C_5=%4d C_3=%4d C_1=%4d C_1_2=%4d C_1_6=%4d\r\n",BAT_C_POINT_20, BAT_C_POINT_10, BAT_C_POINT_5,BAT_C_POINT_3,BAT_C_POINT_1,BAT_C_POINT_1_2,BAT_C_POINT_1_6);
		//printf("U_20=%4d U_10=%4d U_5=%4d U_3=%4d U_1=%4d U_1_2=%4d U_1_6=%4d\r\n",BAT_U_END_20, BAT_U_END_10, BAT_U_END_5,BAT_U_END_3,BAT_U_END_1,BAT_U_END_1_2,BAT_U_END_1_6);
		//printf("NUM_ELEM=%4d K_OLD=%4d \r\n",BAT_C_POINT_NUM_ELEM, BAT_K_OLD);  

		//printf("FZ_U1=%4d FZ_IMAX1=%4d FZ_T1=%4d FZ_ISW12=%4d FZ_U2=%4d FZ_IMAX2=%4d FZ_T2=%4d\r\n", FZ_U1, FZ_IMAX1, FZ_T1, FZ_ISW12, FZ_U2, FZ_IMAX2, FZ_T2);
		printf("%5d \r\n",MODBUS_ADRESS);  
//		printf("UZ_U=%4d UZ_I=%4d UZ_T=%4d UZ_AVT_EN=%4d UZ_DU=%4d UZ_VENT=%4d \r\n", speedChrgVolt, speedChrgCurr, speedChrgTimeInHour, speedChrgAvtEn, speedChrgDU, SP_CH_VENT_BLOK);
	//TZAS=5;
		//printf("NUMIST = %3d UMAX = %3d UMIN = %4d TZAS = %4d UNMIN = %4d UNMAX = %4d TSIGN = %4d TMAX = %4d ZV_ON = %4d\r\n" , NUMIST, UMAX, UB20-DU, TZAS, UMN, UMAXN, TSIGN, TMAX, ZV_ON);
		//printf("IUP = %3d IDN = %3d PAR = %4d U_OUT_MAX = %4d U_OUT_MIN = %4d U_OUT_DELAY = %4d NUMPHASE = %4d RELE1SET = %4x RELE2SET = %4x RELE3SET = %4x \r\n" , IMAX, IMIN, PAR, U_OUT_KONTR_MAX, U_OUT_KONTR_MIN, U_OUT_KONTR_DELAY, NUMPHASE, RELE1SET, RELE2SET, RELE3SET);
		//printf("RELE1 = %3d RELE2 = %3d RELE3 = %4d RELEHV = %4d U_OUT_MIN = %4d U_OUT_DELAY = %4d NUMPHASE = %4d RELE1SET = %4x RELE2SET = %4x RELE3SET = %4x \r\n" , test_hndl_rele1_cntrl, test_hndl_rele2_cntrl, test_hndl_rele3_cntrl, test_hndl_releHV_cntrl, U_OUT_KONTR_MIN, U_OUT_KONTR_DELAY, NUMPHASE, RELE1SET, RELE2SET, RELE3SET);

		//printf("IZMAX=%4d TBAT=%4d UB0=%4d UB20=%4d TBATSIGN=%4d TBATMAX=%4d  IKB=%4d USIGN=%4d \r\n", IZMAX, TBAT, UB0, UB20, TBATSIGN, TBATMAX, IKB, USIGN);

		//RCC->APB1ENR |= RCC_APB1ENR_PWREN;
		//PWR->CR      |= PWR_CR_DBP;
		//BKP->DR1=(BKP->DR1)+1;
		//PWR->CR   &= ~PWR_CR_DBP;
		//printf("%5d %5d %5d %5d %5d %5d %5d %5d %5d\r\n", BKP->DR1, cntrl_stat, modbus_register_995, bps[0]._flags_tu, RTC->CNTH, RTC->CNTL, MODBUS_ADRESS, BKP->DR4, BKP->DR5);
		avg_hndl();

		beep_hndl(); 	//Управление бипером, логическое
		//calendar_hndl();
		factory_settings_hndl();

		#ifdef UKU_220_IPS_TERMOKOMPENSAT
		speedChargeHndl();
		//averageChargeHndl();
		//vz1_drv();
		//vz2_drv();
		#endif
		}
	if(bMODBUS_TIMEOUT)modbus_in();
	/*	{
		bMODBUS_TIMEOUT=0;
		//modbus_plazma++;;
		modbus_in();
		}	*/
	if(bMCP2515_IN)
		{
		bMCP2515_IN=0;
		can_in_an1();
		}
	if(plazma_debug_1)
		{
		plazma_debug_1=0;
		printf("%d;\r\n", plazma_debug_0);
		}
	}
}


/*----------------------------------------------------------------------------
 * end of file
 *---------------------------------------------------------------------------*/
