spa-pal/UKU201/SOFT/1/memo.c

#include <stm32f10x_lib.h>
//#include <stm32f10x_conf.h>
#include "25lc640.h"
#include "memo.h"
#include "eeprom_map.h"
#include "main.h"
//#include "snmp_data_file.h"
//#include "control.h"
#include "gran.h"


//-----------------------------------------------
void memo_first_init (void)
{
if(lc640_read_int(EE_MEMORY_IS_INITIALIZED)!=0x1234)
	{
	lc640_write_int(EE_MODBUS_ADRESS,1);
	lc640_write_int(EE_MODBUS_BAUDRATE,960);

	lc640_write_int(EE_MEMORY_IS_INITIALIZED,0x1234);
	}
}


//-----------------------------------------------
void memo_read (void)
{
char i;
//Ktsrc[0]=lc640_read_int(KTSRC1);

//Ktsrc[1]=lc640_read_int(KTSRC2);
//Kusrc[0]=lc640_read_int(KUSRC1);
//Kusrc[1]=lc640_read_int(KUSRC2);
//Kisrc[0]=lc640_read_int(KISRC1);
//Kisrc[1]=lc640_read_int(KISRC2);
//Ki0src[0]=lc640_read_int(KI0SRC1);
//Ki0src[1]=lc640_read_int(KI0SRC2);

Kubat[0]=lc640_read_int(EE_KUBAT1);
Kubat[1]=lc640_read_int(EE_KUBAT2);
Kubatm[0]=lc640_read_int(EE_KUBATM1);
Kubatm[1]=lc640_read_int(EE_KUBATM2);
Kibat0[0]=lc640_read_int(EE_KI0BAT1);
Kibat0[1]=lc640_read_int(EE_KI0BAT2);
Kibat1[0]=lc640_read_int(EE_KI1BAT1);
Kibat1[1]=lc640_read_int(EE_KI1BAT2);
Ktbat[0]=lc640_read_int(EE_KTBAT1);
Ktbat[1]=lc640_read_int(EE_KTBAT2);
Kunet=lc640_read_int(EE_KUNET);
Kuload=lc640_read_int(EE_KULOAD);
Kunet_ext[0]=lc640_read_int(EE_KUNET_EXT0);
Kunet_ext[1]=lc640_read_int(EE_KUNET_EXT1);
Kunet_ext[2]=lc640_read_int(EE_KUNET_EXT2);
//Kvv_eb2[0]=lc640_read_int(EE_KVV0_EB2);
//Kvv_eb2[1]=lc640_read_int(EE_KVV1_EB2);
//Kvv_eb2[2]=lc640_read_int(EE_KVV2_EB2);
//Kpes_eb2[0]=lc640_read_int(EE_KPES0_EB2);
//Kpes_eb2[1]=lc640_read_int(EE_KPES1_EB2);
//Kpes_eb2[2]=lc640_read_int(EE_KPES2_EB2);
KunetA=lc640_read_int(EE_KUNETA);
KunetB=lc640_read_int(EE_KUNETB);
KunetC=lc640_read_int(EE_KUNETC);
Kubps=lc640_read_int(EE_KUBPS);
Kuout=lc640_read_int(EE_KUOUT);

Ktext[0]=lc640_read_int(KT_EXT0);
Ktext[1]=lc640_read_int(KT_EXT1);
Ktext[2]=lc640_read_int(KT_EXT2);
	
MAIN_IST=lc640_read_int(EE_MAIN_IST);
UMAX=lc640_read_int(EE_UMAX);
UB0=lc640_read_int(EE_UB0);
UB20=lc640_read_int(EE_UB20);
TMAX=lc640_read_int(EE_TMAX);
TSIGN=lc640_read_int(EE_TSIGN);
DU=lc640_read_int(EE_DU);
USIGN=lc640_read_int(EE_USIGN);
UMN=lc640_read_int(EE_UMN);
UMAXN=lc640_read_int(EE_UMAXN);
ZV_ON=lc640_read_int(EE_ZV_ON);
IKB=lc640_read_int(EE_IKB);
UVZ=lc640_read_int(EE_UVZ);
IMAX_VZ=lc640_read_int(EE_IMAX_VZ);
SMART_SPC=lc640_read_int(EE_SMART_SPC);
IMAX=lc640_read_int(EE_IMAX);
IMIN=lc640_read_int(EE_IMIN);
APV_ON=lc640_read_int(EE_APV_ON);
RS485_QWARZ_DIGIT=lc640_read_int(EE_RS485_QWARZ_DIGIT);
SNTP_ENABLE=lc640_read_int(EE_SNTP_ENABLE);
SNTP_GMT=lc640_read_int(EE_SNTP_GMT);
UZ_U=lc640_read_int(EE_UZ_U);
UZ_IMAX=lc640_read_int(EE_UZ_IMAX);
UZ_T=lc640_read_int(EE_UZ_T);
FZ_U1=lc640_read_int(EE_FZ_U1);	
FZ_IMAX1=lc640_read_int(EE_FZ_IMAX1);
FZ_T1=lc640_read_int(EE_FZ_T1);					
FZ_ISW12=lc640_read_int(EE_FZ_ISW12);				
FZ_U2=lc640_read_int(EE_FZ_U2);					
FZ_IMAX2=lc640_read_int(EE_FZ_IMAX2);		
FZ_T2=lc640_read_int(EE_FZ_T2);				
UVENTOFF=lc640_read_int(EE_UVENTOFF);
IZMAX=lc640_read_int(EE_IZMAX);
U0B=lc640_read_int(EE_U0B);
TZAS=lc640_read_int(EE_TZAS);
//TZAS=7;
NUMIST=lc640_read_int(EE_NUMIST);
#ifdef UKU_ZVU
NUMBAT=lc640_read_int(EE_NUMBAT);
#endif
NUMBAT_TELECORE=lc640_read_int(EE_NUMBAT_TELECORE);
//gran(&NUMIST,0,8);
NUMINV=lc640_read_int(EE_NUMINV);
gran(&NUMINV,0,15);
NUMSK=lc640_read_int(EE_NUMSK);
NUMDT=lc640_read_int(EE_NUMDT);
NUMAVT=lc640_read_int(EE_NUMAVT);
NUMMAKB=lc640_read_int(EE_NUMMAKB);
NUMEXT=NUMSK+NUMDT;
NUMBDR=lc640_read_int(EE_NUMBDR);
NUMENMV=lc640_read_int(EE_NUMENMV);
NUMPHASE=lc640_read_int(EE_NUMPHASE);
AV_OFF_AVT=lc640_read_int(EE_AV_OFF_AVT);
//MNEMO_ON=(enum_mnemo_on)lc640_read_int(EE_MNEMO_ON);
//MNEMO_TIME=lc640_read_int(EE_MNEMO_TIME);
U_AVT=lc640_read_int(EE_U_AVT);
PAR=lc640_read_int(EE_PAR);
TBATMAX=lc640_read_int(EE_TBATMAX);
TBATSIGN=lc640_read_int(EE_TBATSIGN);
UBM_AV=lc640_read_int(EE_UBM_AV);
RELE_LOG=lc640_read_int(EE_RELE_LOG);
TBOXMAX=lc640_read_int(EE_TBOXMAX);
TBOXREG=lc640_read_int(EE_TBOXREG);
TBOXVENTMAX=lc640_read_int(EE_TBOXVENTMAX);
TLOADDISABLE=lc640_read_int(EE_TLOADDISABLE);
TLOADENABLE=lc640_read_int(EE_TLOADENABLE);
TBATDISABLE=lc640_read_int(EE_TBATDISABLE);
TBATENABLE=lc640_read_int(EE_TBATENABLE);
TVENTON=lc640_read_int(EE_TVENTON);
TVENTOFF=lc640_read_int(EE_TVENTOFF);
TWARMON=lc640_read_int(EE_TWARMON);
TWARMOFF=lc640_read_int(EE_TWARMOFF);
RELEVENTSIGN=(enum_releventsign)lc640_read_int(EE_RELEVENTSIGN);
NPN_OUT=(enum_npn_out)lc640_read_int(EE_NPN_OUT);
NPN_SIGN=(enum_npn_sign)lc640_read_int(EE_NPN_SIGN);
UONPN=lc640_read_int(EE_UONPN);
UVNPN=lc640_read_int(EE_UVNPN);
TZNPN=lc640_read_int(EE_TZNPN);
dUNPN=lc640_read_int(EE_dUNPN);
TERMOKOMPENS=lc640_read_int(EE_TERMOKOMP);
TBOXVENTON=lc640_read_int(EE_TBOXVENTON);
TBOXVENTOFF=lc640_read_int(EE_TBOXVENTOFF);
TBOXWARMON=lc640_read_int(EE_TBOXWARMON);
TBOXWARMOFF=lc640_read_int(EE_TBOXWARMOFF);
NUMBYPASS=lc640_read_int(EE_NUMBYPASS);
BAT_TYPE=lc640_read_int(EE_BAT_TYPE); 

speedChrgCurr =lc640_read_int(EE_SPEED_CHRG_CURR); 
speedChrgVolt =lc640_read_int(EE_SPEED_CHRG_VOLT);
speedChrgTimeInHour =lc640_read_int(EE_SPEED_CHRG_TIME);
speedChrgAvtEn =lc640_read_int(EE_SPEED_CHRG_AVT_EN);
//speedChrgBlckSrc=lc640_read_int(EE_SPEED_CHRG_BLOCK_SRC);
//speedChrgBlckLog=lc640_read_int(EE_SPEED_CHRG_BLOCK_LOG);
speedChrgDU=lc640_read_int(EE_SPEED_CHRG_D_U);
SP_CH_VENT_BLOK=lc640_read_int(EE_SP_CH_VENT_BLOK);
DU_LI_BAT=lc640_read_int(EE_DU_LI_BAT);
FORVARDBPSCHHOUR=lc640_read_int(EE_FORVARDBPSCHHOUR);
U_OUT_KONTR_MAX=lc640_read_int(EE_U_OUT_KONTR_MAX);
U_OUT_KONTR_MIN=lc640_read_int(EE_U_OUT_KONTR_MIN);
U_OUT_KONTR_DELAY=lc640_read_int(EE_U_OUT_KONTR_DELAY);
DOP_RELE_FUNC=lc640_read_int(EE_DOP_RELE_FUNC);
//ipsBlckSrc=lc640_read_int(EE_IPS_BLOCK_SRC);
//ipsBlckLog=lc640_read_int(EE_IPS_BLOCK_LOG);
CNTRL_HNDL_TIME=lc640_read_int(EE_CNTRL_HNDL_TIME);
USODERG_LI_BAT=lc640_read_int(EE_USODERG_LI_BAT);
QSODERG_LI_BAT=lc640_read_int(EE_QSODERG_LI_BAT);
TVENTMAX=lc640_read_int(EE_TVENTMAX);
ICA_EN=lc640_read_int(EE_ICA_EN);
ICA_CH=lc640_read_int(EE_ICA_CH);
ICA_MODBUS_ADDRESS=lc640_read_int(EE_ICA_MODBUS_ADDRESS);
ICA_MODBUS_TCP_IP1=lc640_read_int(EE_ICA_MODBUS_TCP_IP1);
ICA_MODBUS_TCP_IP2=lc640_read_int(EE_ICA_MODBUS_TCP_IP2);
ICA_MODBUS_TCP_IP3=lc640_read_int(EE_ICA_MODBUS_TCP_IP3);
ICA_MODBUS_TCP_IP4=lc640_read_int(EE_ICA_MODBUS_TCP_IP4);
ICA_MODBUS_TCP_UNIT_ID=lc640_read_int(EE_ICA_MODBUS_TCP_UNIT_ID);
PWM_START=lc640_read_int(EE_PWM_START);
KB_ALGORITM=lc640_read_int(EE_KB_ALGORITM);
REG_SPEED=lc640_read_int(EE_REG_SPEED);
BAT_IS_ON[0]=(enum_bat_is_on)lc640_read_int(EE_BAT1_IS_ON);
BAT_IS_ON[1]=(enum_bat_is_on)lc640_read_int(EE_BAT2_IS_ON);	
#ifndef UKU_ZVU
NUMBAT=0;
if(BAT_IS_ON[0]==bisON)NUMBAT+=1;
if(BAT_IS_ON[1]==bisON)NUMBAT+=1;
#endif

BAT_DAY_OF_ON[0]=lc640_read_int(EE_BAT1_DAY_OF_ON);
BAT_MONTH_OF_ON[0]=lc640_read_int(EE_BAT1_MONTH_OF_ON);
BAT_YEAR_OF_ON[0]=lc640_read_int(EE_BAT1_YEAR_OF_ON);
BAT_C_REAL[0]=lc640_read_int(EE_BAT1_C_REAL);
BAT_C_NOM[0]=lc640_read_int(EE_BAT1_C_NOM);
BAT_RESURS[0]=lc640_read_int(EE_BAT1_RESURS);


BAT_DAY_OF_ON[1]=lc640_read_int(EE_BAT2_DAY_OF_ON);
BAT_MONTH_OF_ON[1]=lc640_read_int(EE_BAT2_MONTH_OF_ON);
BAT_YEAR_OF_ON[1]=lc640_read_int(EE_BAT2_YEAR_OF_ON);
BAT_C_REAL[1]=lc640_read_int(EE_BAT2_C_REAL);
BAT_C_NOM[1]=lc640_read_int(EE_BAT2_C_NOM);
BAT_RESURS[1]=lc640_read_int(EE_BAT2_RESURS);


BAT_LINK=lc640_read_int(EE_BAT_LINK);

APV_ON1=(enum_apv_on)lc640_read_int(EE_APV_ON1);
APV_ON2=(enum_apv_on)lc640_read_int(EE_APV_ON2);
APV_ON2_TIME=lc640_read_int(EE_APV_ON2_TIME);
VZ_HR=lc640_read_int(EE_VZ_HR);
TBAT=lc640_read_int(EE_TBAT);

AUSW_MAIN=lc640_read_int(EE_AUSW_MAIN);
AUSW_MAIN_NUMBER=lc640_read_long(EE_AUSW_MAIN_NUMBER);
//	AUSW_DAY=lc640_read_int(EE_AUSW_DAY);
//	AUSW_MONTH=lc640_read_int(EE_AUSW_MONTH);
//	AUSW_YEAR=lc640_read_int(EE_AUSW_YEAR);
//	AUSW_BPS1_NUMBER=lc640_read_long(EE_AUSW_BPS1_NUMBER);
//	AUSW_BPS2_NUMBER=lc640_read_long(EE_AUSW_BPS2_NUMBER);
//	AUSW_RS232=lc640_read_int(EE_AUSW_RS232);
//	AUSW_PDH=lc640_read_int(EE_AUSW_PDH);
//	AUSW_SDH=lc640_read_int(EE_AUSW_SDH);
//	AUSW_ETH=lc640_read_int(EE_AUSW_ETH);
//	AUSW_UKU=lc640_read_int(EE_AUSW_UKU);
//	AUSW_UKU_SUB=lc640_read_int(EE_AUSW_UKU_SUB);
AUSW_UKU_NUMBER=lc640_read_long(EE_AUSW_UKU_NUMBER);			


TMAX_EXT_EN[0]=lc640_read_int(EE_TMAX_EXT_EN0);
TMAX_EXT[0]=lc640_read_int(EE_TMAX_EXT0);
TMIN_EXT_EN[0]=lc640_read_int(EE_TMIN_EXT_EN0);
TMIN_EXT[0]=lc640_read_int(EE_TMIN_EXT0);	
T_EXT_REL_EN[0]=lc640_read_int(EE_T_EXT_REL_EN0);
T_EXT_ZVUK_EN[0]=lc640_read_int(EE_T_EXT_ZVUK_EN0);
T_EXT_LCD_EN[0]=lc640_read_int(EE_T_EXT_LCD_EN0);
T_EXT_RS_EN[0]=lc640_read_int(EE_T_EXT_RS_EN0);
SK_SIGN[0]=lc640_read_int(EE_SK_SIGN0);
SK_REL_EN[0]=lc640_read_int(EE_SK_REL_EN0);
SK_ZVUK_EN[0]=lc640_read_int(EE_SK_ZVUK_EN0);
SK_LCD_EN[0]=lc640_read_int(EE_SK_LCD_EN0);	
SK_RS_EN[0]=lc640_read_int(EE_SK_RS_EN0);
SK_SIGN[1]=lc640_read_int(EE_SK_SIGN1);
SK_REL_EN[1]=lc640_read_int(EE_SK_REL_EN1);
SK_ZVUK_EN[1]=lc640_read_int(EE_SK_ZVUK_EN1);
SK_LCD_EN[1]=lc640_read_int(EE_SK_LCD_EN1);	
SK_RS_EN[1]=lc640_read_int(EE_SK_RS_EN1);
SK_SIGN[2]=lc640_read_int(EE_SK_SIGN2);
SK_REL_EN[2]=lc640_read_int(EE_SK_REL_EN2);
SK_ZVUK_EN[2]=lc640_read_int(EE_SK_ZVUK_EN2);
SK_LCD_EN[2]=lc640_read_int(EE_SK_LCD_EN2);	
SK_RS_EN[2]=lc640_read_int(EE_SK_RS_EN2);
SK_SIGN[3]=lc640_read_int(EE_SK_SIGN3);
SK_REL_EN[3]=lc640_read_int(EE_SK_REL_EN3);
SK_ZVUK_EN[3]=lc640_read_int(EE_SK_ZVUK_EN3);
SK_LCD_EN[3]=lc640_read_int(EE_SK_LCD_EN3);	
SK_RS_EN[3]=lc640_read_int(EE_SK_RS_EN3);
RELE_VENT_LOGIC=lc640_read_int(EE_RELE_VENT_LOGIC);


AVZ=(enum_avz)(lc640_read_int(EE_AVZ));
AVZ_TIME=lc640_read_int(EE_AVZ_TIME);
HOUR_AVZ=lc640_read_int(EE_HOUR_AVZ);
MIN_AVZ=lc640_read_int(EE_MIN_AVZ);
SEC_AVZ=lc640_read_int(EE_SEC_AVZ);
DATE_AVZ=lc640_read_int(EE_DATE_AVZ);
MONTH_AVZ=lc640_read_int(EE_MONTH_AVZ);
if(!((MONTH_AVZ>0)&&(MONTH_AVZ<13)))MONTH_AVZ=0;
YEAR_AVZ=lc640_read_int(EE_YEAR_AVZ);

//pos_vent=lc640_read_int(EE_POS_VENT);
//POWER_CNT_ADRESS=lc640_read_int(EE_POWER_CNT_ADRESS);
/*
ETH_IS_ON=lc640_read_int(EE_ETH_IS_ON);
ETH_DHCP_ON=lc640_read_int(EE_ETH_DHCP_ON);
ETH_IP_1=lc640_read_int(EE_ETH_IP_1);
ETH_IP_2=lc640_read_int(EE_ETH_IP_2);
ETH_IP_3=lc640_read_int(EE_ETH_IP_3);
ETH_IP_4=lc640_read_int(EE_ETH_IP_4);
ETH_MASK_1=lc640_read_int(EE_ETH_MASK_1);
ETH_MASK_2=lc640_read_int(EE_ETH_MASK_2);
ETH_MASK_3=lc640_read_int(EE_ETH_MASK_3);
ETH_MASK_4=lc640_read_int(EE_ETH_MASK_4);
ETH_GW_1=lc640_read_int(EE_ETH_GW_1);
ETH_GW_2=lc640_read_int(EE_ETH_GW_2);
ETH_GW_3=lc640_read_int(EE_ETH_GW_3);
ETH_GW_4=lc640_read_int(EE_ETH_GW_4);
ETH_TRAP1_IP_1=lc640_read_int(EE_ETH_TRAP1_IP_1);
ETH_TRAP1_IP_2=lc640_read_int(EE_ETH_TRAP1_IP_2);
ETH_TRAP1_IP_3=lc640_read_int(EE_ETH_TRAP1_IP_3);
ETH_TRAP1_IP_4=lc640_read_int(EE_ETH_TRAP1_IP_4);
ETH_TRAP2_IP_1=lc640_read_int(EE_ETH_TRAP2_IP_1);
ETH_TRAP2_IP_2=lc640_read_int(EE_ETH_TRAP2_IP_2);
ETH_TRAP2_IP_3=lc640_read_int(EE_ETH_TRAP2_IP_3);
ETH_TRAP2_IP_4=lc640_read_int(EE_ETH_TRAP2_IP_4);
ETH_TRAP3_IP_1=lc640_read_int(EE_ETH_TRAP3_IP_1);
ETH_TRAP3_IP_2=lc640_read_int(EE_ETH_TRAP3_IP_2);
ETH_TRAP3_IP_3=lc640_read_int(EE_ETH_TRAP3_IP_3);
ETH_TRAP3_IP_4=lc640_read_int(EE_ETH_TRAP3_IP_4);
ETH_TRAP4_IP_1=lc640_read_int(EE_ETH_TRAP4_IP_1);
ETH_TRAP4_IP_2=lc640_read_int(EE_ETH_TRAP4_IP_2);
ETH_TRAP4_IP_3=lc640_read_int(EE_ETH_TRAP4_IP_3);
ETH_TRAP4_IP_4=lc640_read_int(EE_ETH_TRAP4_IP_4);
ETH_TRAP5_IP_1=lc640_read_int(EE_ETH_TRAP5_IP_1);
ETH_TRAP5_IP_2=lc640_read_int(EE_ETH_TRAP5_IP_2);
ETH_TRAP5_IP_3=lc640_read_int(EE_ETH_TRAP5_IP_3);
ETH_TRAP5_IP_4=lc640_read_int(EE_ETH_TRAP5_IP_4);
ETH_SNMP_PORT_READ=lc640_read_int(EE_ETH_SNMP_PORT_READ);
ETH_SNMP_PORT_WRITE=lc640_read_int(EE_ETH_SNMP_PORT_WRITE);*/
MODBUS_ADRESS=lc640_read_int(EE_MODBUS_ADRESS);
//MODBUS_ADRESS=1;
MODBUS_BAUDRATE=lc640_read_int(EE_MODBUS_BAUDRATE);
RELE1SET=lc640_read_int(EE_RELE1SET);
RELE2SET=lc640_read_int(EE_RELE2SET);
RELE3SET=lc640_read_int(EE_RELE3SET);
//RELE_SET_MASK[3]=lc640_read_int(EE_RELE_SET_MASK3);
//*/num_rki=(char)lc640_read_int(EE_NUM_RKI);
//if(num_rki>1) {num_rki=0; lc640_write_int(EE_NUM_RKI, num_rki);}
//num_net_in=(char)lc640_read_int(EE_NUM_NET_IN);
//*/hv_vz_stat=(enum_hv_vz_stat)lc640_read_int(EE_HV_VZ_STAT);
//*/vz1_stat=(enum_vz1_stat)lc640_read_int(EE_VZ1_STAT);
//*/if(vz1_stat==255)vz1_stat=vz1sOFF;
//*/vz2_stat=(enum_vz2_stat)lc640_read_int(EE_VZ2_STAT);
//*/if(vz2_stat==255)vz2_stat=vz2sOFF;
VZ_KIND=lc640_read_int(EE_VZ_KIND);
BAT_C_POINT_1_6=lc640_read_int(EE_BAT_C_POINT_1_6);
BAT_C_POINT_1_2=lc640_read_int(EE_BAT_C_POINT_1_2);
BAT_C_POINT_1=lc640_read_int(EE_BAT_C_POINT_1);				
BAT_C_POINT_3=lc640_read_int(EE_BAT_C_POINT_3);
BAT_C_POINT_5=lc640_read_int(EE_BAT_C_POINT_5);
BAT_C_POINT_10=lc640_read_int(EE_BAT_C_POINT_10);
BAT_C_POINT_20=lc640_read_int(EE_BAT_C_POINT_20);
BAT_U_END_1_6=lc640_read_int(EE_BAT_U_END_1_6);
BAT_U_END_1_2=lc640_read_int(EE_BAT_U_END_1_2);
BAT_U_END_1=lc640_read_int(EE_BAT_U_END_1);				
BAT_U_END_3=lc640_read_int(EE_BAT_U_END_3);
BAT_U_END_5=lc640_read_int(EE_BAT_U_END_5);
BAT_U_END_10=lc640_read_int(EE_BAT_U_END_10);
BAT_U_END_20=lc640_read_int(EE_BAT_U_END_20);
BAT_C_POINT_NUM_ELEM=lc640_read_int(EE_BAT_C_POINT_NUM_ELEM);
BAT_K_OLD=lc640_read_int(EE_BAT_K_OLD);

//*/SP_CH_VENT_BLOK=lc640_read_int(EE_SP_CH_VENT_BLOK);
//*/VZ_CH_VENT_BLOK=lc640_read_int(EE_VZ_CH_VENT_BLOK);

for(i=0;i<64;i++)
	{
	//*/snmp_location[i]=lc640_read(EE_LOCATION+i);
	}
for(i=0;i<10;i++)
	{
	//*/snmp_community[i]=lc640_read(EE_COMMUNITY+(i*2));
	}
for(i=0;i<64;i++)
	{
	//*/place_holder[i]=lc640_read(EE_HTTP_LOCATION+i);
	}


__ee_vz_cnt=lc640_read_int(EE_VZ_CNT);
__ee_spc_stat=lc640_read_int(EE_SPC_STAT);
__ee_spc_bat=lc640_read_int(EE_SPC_BAT);
__ee_spc_phase=lc640_read_int(EE_SPC_PHASE);
}
