spa-pal/UKU201/SOFT/1/modbus.h

extern short modbus_error_cntr;

extern unsigned char modbus_buf[20];
extern short modbus_crc16;
extern char modbus_timeout_cnt;
extern char bMODBUS_TIMEOUT;
extern unsigned char modbus_rx_buffer[100];	//Буфер, куда складывает принимаемые даннные обработчик прерывания по приему УАРТа
extern unsigned char modbus_an_buffer[100];	//Буфер, куда они потом копируются для анализа
extern unsigned char modbus_rx_buffer_ptr;	//Указатель на текущую позицию принимающего буфера
extern unsigned char modbus_rx_counter;		//Количество принятых байт, используется при анализе целостности посылки и при расшифровке

extern short modbus_plazma;				//Отладка
extern short modbus_plazma1;				//Отладка
extern short modbus_plazma2;				//Отладка
extern short modbus_plazma3;				//Отладка

extern unsigned short modbus_rx_arg0;		//встроенный в посылку первый аргумент
extern unsigned short modbus_rx_arg1;		//встроенный в посылку второй аргумент
extern unsigned short modbus_rx_arg2;		//встроенный в посылку третий аргумент
extern unsigned short modbus_rx_arg3;		//встроенный в посылку четвертый аргумент

extern short modbus_register_offset;
extern short modbus_register_offset_ui;
extern short modbus_register_offset_un;
extern short modbus_register_offset_i;
extern short modbus_register_offset_t;
extern short modbus_register_995, modbus_register_996, modbus_register_997;
extern short modbus_register_998;
extern short modbus_register_999;
extern short modbus_register_1000, modbus_register_1001, modbus_register_1002, modbus_register_1003, modbus_register_1022;


extern char modbus_tx_buff[500];

//extern char modbus_registers[200];
//-----------------------------------------------
unsigned short CRC16_2(char* buf, short len);
//-----------------------------------------------
//void modbus_registers_transmit(unsigned char adr,unsigned char func,unsigned short reg_adr,unsigned short reg_quantity);
//-----------------------------------------------
//void modbus_register_transmit(unsigned char adr,unsigned char func,unsigned short reg_adr);
//-----------------------------------------------
void modbus_hold_registers_transmit(unsigned char adr,unsigned char func,unsigned short reg_adr,unsigned short reg_quantity, char prot);
//-----------------------------------------------
void modbus_input_registers_transmit(unsigned char adr,unsigned char func,unsigned short reg_adr,unsigned short reg_quantity, char prot);
//-----------------------------------------------
//void modbus_hold_register_transmit(unsigned char adr,unsigned char func,unsigned short reg_adr);
void modbus_in(void);
