spa-pal/UKU201/SOFT/1/beep.h

extern bool bSILENT;
extern unsigned long beep_stat_temp,beep_stat;
extern signed short  beep_stat_cnt;
extern char beep_cnt;
extern char bU_BAT2REL_AV_BAT;


void beep_drv(void);
void beep_init(long zvuk,char fl);
void beep_hndl(void);
