spa-pal/UKU201/SOFT/1/mess.h

extern char mess[MESS_DEEP],mess_old[MESS_DEEP],mess_cnt[MESS_DEEP];
extern int mess_par0[MESS_DEEP],mess_par1[MESS_DEEP],mess_data[2];




#define 	MESS_BAT_ON_OFF	160
#define   _MESS_BAT_MASK_BLOK_AFTER_2SEC		161
#define	_MESS_BAT_MASK_ON					162
#define	_MESS_BAT_MASK_OFF					163

		
#define	MESS_SPA_UART_SRAM	200 
#define	MESS_SPA_UART_CMND	201 



void mess_hndl(void);
void mess_send(char _mess, short par0, short par1, char _time);
char mess_find(char _mess);
char mess_find_unvol(char _mess);
