spa-pal/UKU201/SOFT/1/cmd.h

	  //-----------------------------------------------
// Символы передач
#define REGU 0xf5
#define REGI 0xf6
#define GetTemp 0xfc
#define TVOL0 0x75
#define TVOL1 0x76
#define TVOL2 0x77
#define TVOL3 0x78
#define TVOL4 0x79
#define TVOL5 0x7A
#define TVOL6 0x7A
#define TVOL7 0x7A
#define TTEMPER	0x7c
#define CSTART  0x1a
#define CMND	0x16
#define Blok_flip	0x57
#define END 	0x0A
#define QWEST	0x25
#define IM	0x52
#define ADD_KF 0x60
#define SUB_KF 0x61
#define Zero_kf0 0x63
#define Zero_kf2 0x64
#define MEM_KF 0x62
#define PUT_BDR 0x69
#define BLKON 0x80
#define BLKOFF 0x81
#define Put_reg 0x90
#define PUTID 0x91
#define PUTTM1 0xDA
#define PUTTM2 0xDB
#define PUTTM1INV2 0xDD
#define PUTTM2INV2 0xDE
#define PUTTM3INV2 0xDf
#define PUTTM_NET 0xEA
#define PUTTM_NET1 0xEB
#define PUTTM_IBATMETER 0xD1
#define GETTM_IBATMETER 0x1D
#define PUTTM 0xDE
#define GETTM 0xED 
#define GETTM_INV 0xFD 
#define GET_MAKB 0xE1 
#define PUTTM_MAKB1		0xE2
#define PUTTM_MAKB2		0xE3
#define PUTTM_MAKB3		0xE4
#define KLBR 0xEE
#define KLBR_MAKB 0xEF
#define MEM_KF 0x62 
#define MEM_KF1 0x26
#define ALRM_RES 0x63
#define VENT_RES 0x64
#define PUTTM1BYPS 0xD8
#define PUTTM2BYPS 0xD9
#define PUT_LB_TM1 	0x18
#define PUT_LB_TM2 	0x78
#define PUT_LB_TM3 	0x38
#define PUT_LB_TM4 	0x48
#define PUT_LB_TM5 	0x58
#define PUT_LB_TM6 	0x68
#define PUT_ZTT_TM1 	0xC1
#define PUT_ZTT_TM2 	0xC2
#define PUT_ZTT_TM3 	0xC3
#define PUT_ZTT_TM4 	0xC4
#define PUT_ZTT_TM5 	0xC5
#define PUT_ZTT_TM6 	0xC6
#define PUT_ZTT_TM7 	0xC7
#define PUT_ZTT_TM8 	0xC8
#define PUT_STARK_TM1 	0xB1
#define PUT_STARK_TM2 	0xB2
#define PUT_STARK_TM3 	0xB3
#define PUT_STARK_TM4 	0xB4
#define PUT_STARK_TM5 	0xB5
#define PUT_STARK_TM6 	0xB6
#define PUT_STARK_TM7 	0xB7
#define PUT_STARK_TM8 	0xB8
#define PUT_STARK_TM9 	0xB9
