spa-pal/UKU201/(commit log)

2019-06-03 Начало софта.
    [UKU201.PrjPCB, can.SchDoc, cpu_board.SchDoc, rs485.SchDoc, uku201.PcbDoc, uku201.xls, uku201.xlsx]
2019-12-19 Вторая версия платы
    [UKU201.PrjPCB, can.SchDoc, cpu_board.SchDoc, rs485.SchDoc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]
2020-05-18 Состояние перед переделыванием на новую концепцию
